BrunoSavard1/CI3-Noeud-de-capteur-/3DModels/Boitier/boitiersc.png

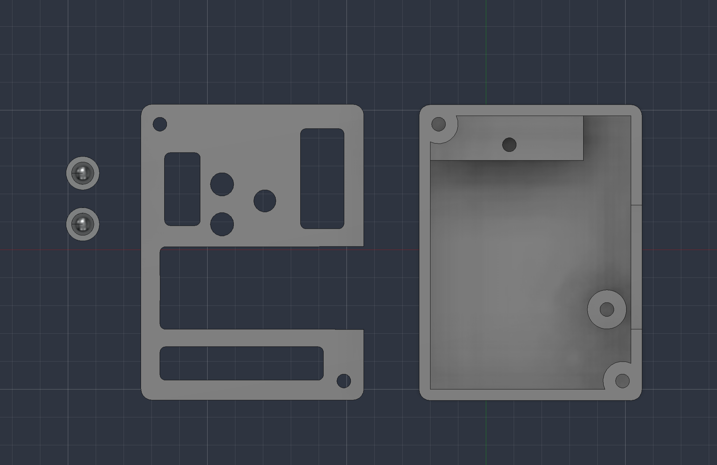
3DModels/Boitier/boitiersc.png
