BrunoSavard1/CI3-Noeud-de-capteur-/3DModels/PCB/pcbdessous.png

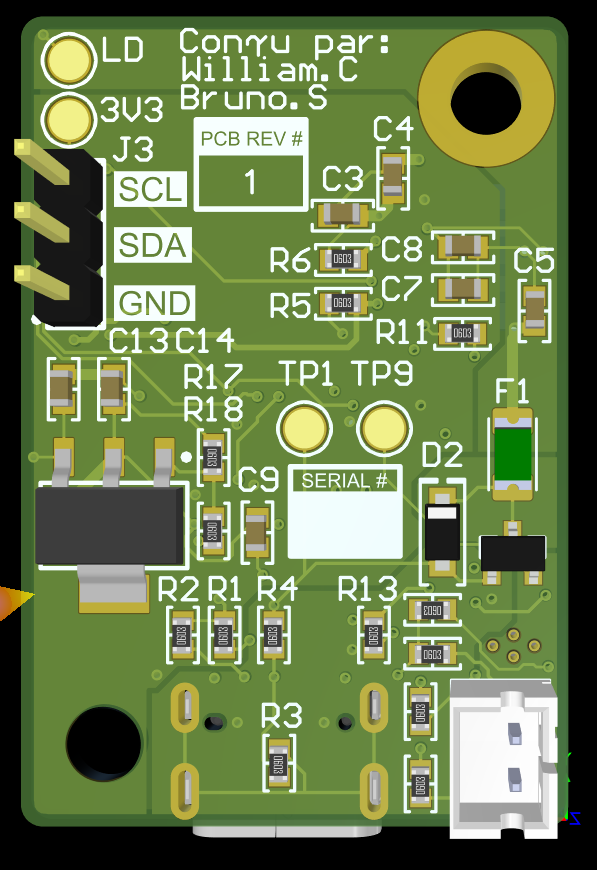
3DModels/PCB/pcbdessous.png
