BrunoSavard1/CI3-Noeud-de-capteur-/3DModels/PCB/pcbdessus.png

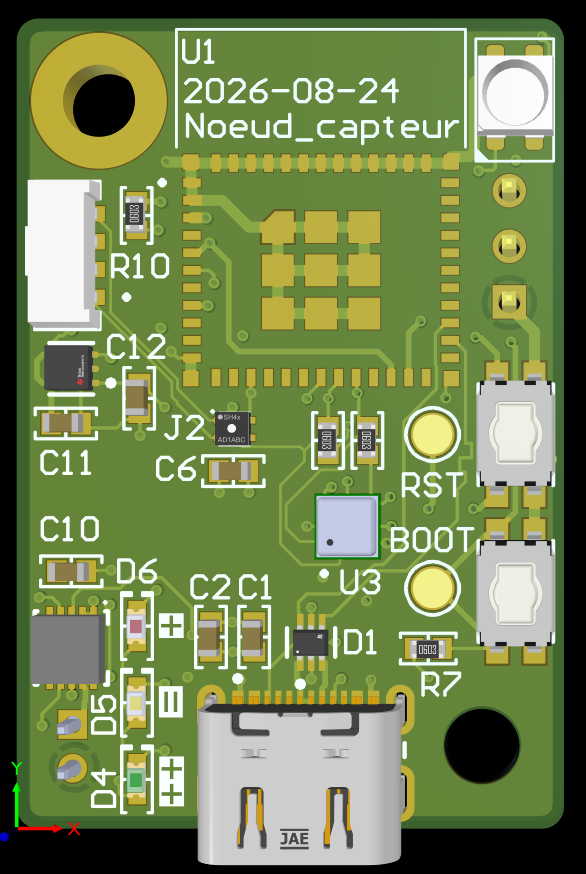
3DModels/PCB/pcbdessus.png
