BrunoSavard1/CI3-Noeud-de-capteur-/PCB/PCB/images/bottom.png

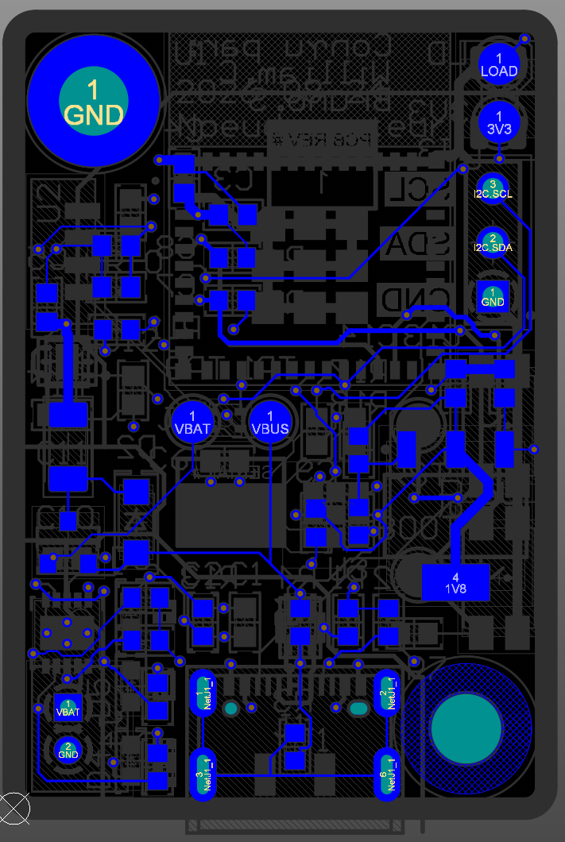
PCB/PCB/images/bottom.png
