BrunoSavard1/CI3-Noeud-de-capteur-/PCB/PCB/images/silkscreenbottom.png

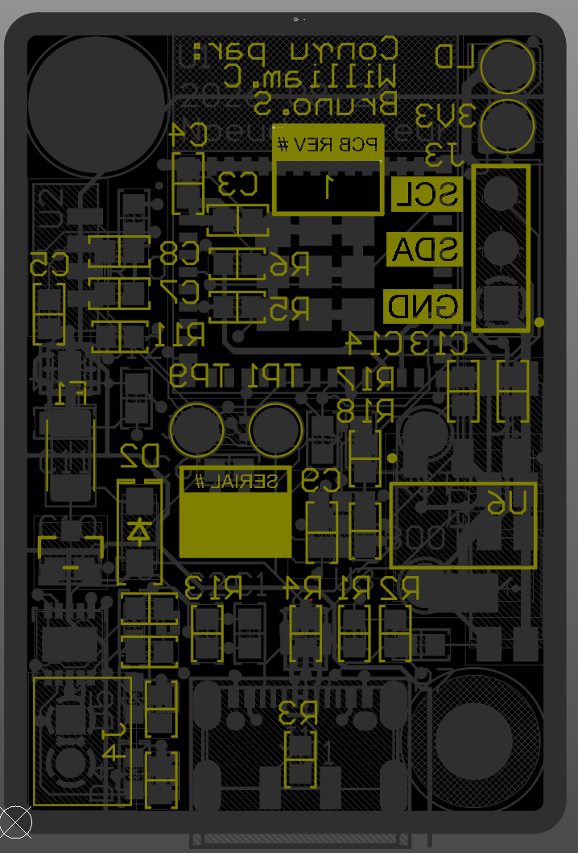
PCB/PCB/images/silkscreenbottom.png
