BrunoSavard1/CI3-Noeud-de-capteur-/PCB/PCB/images/silkscreentop.png

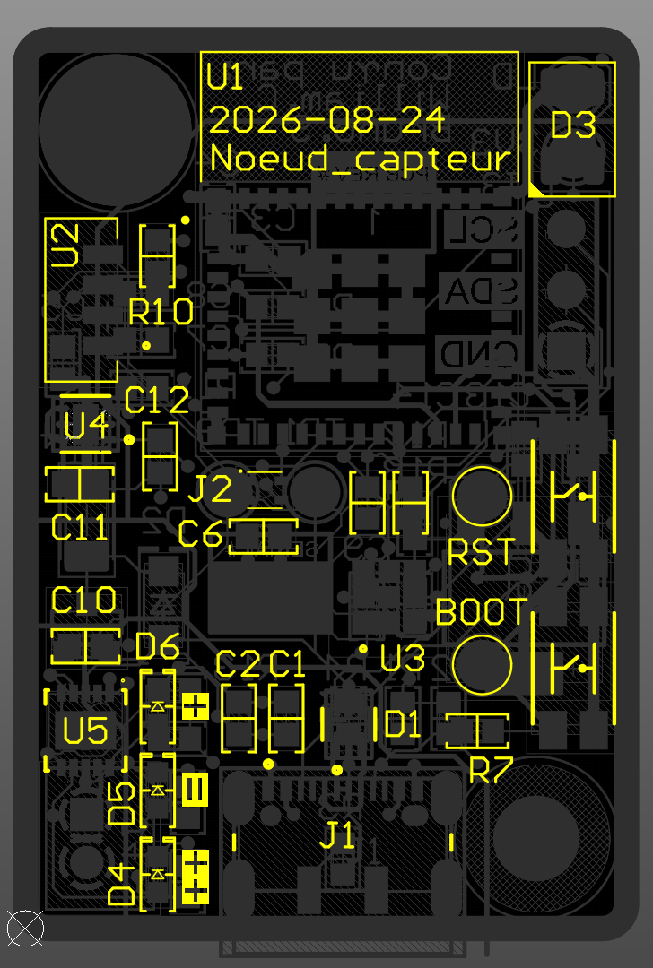
PCB/PCB/images/silkscreentop.png
