BrunoSavard1/CI3-Noeud-de-capteur-/PCB/PCB/images/top.png

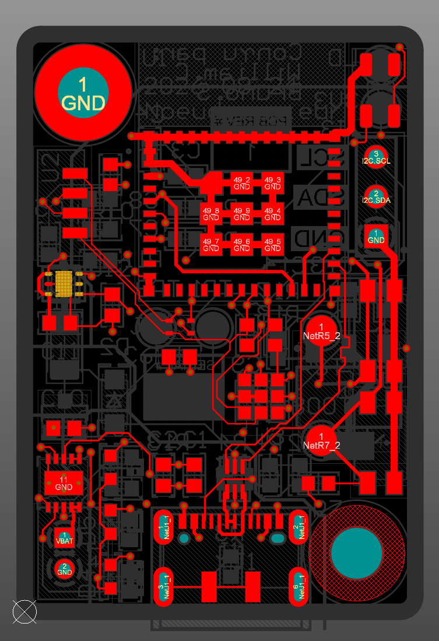
PCB/PCB/images/top.png
