BrunoSavard1/CI3-Noeud-de-capteur-/Schematics/ordinogramme.png

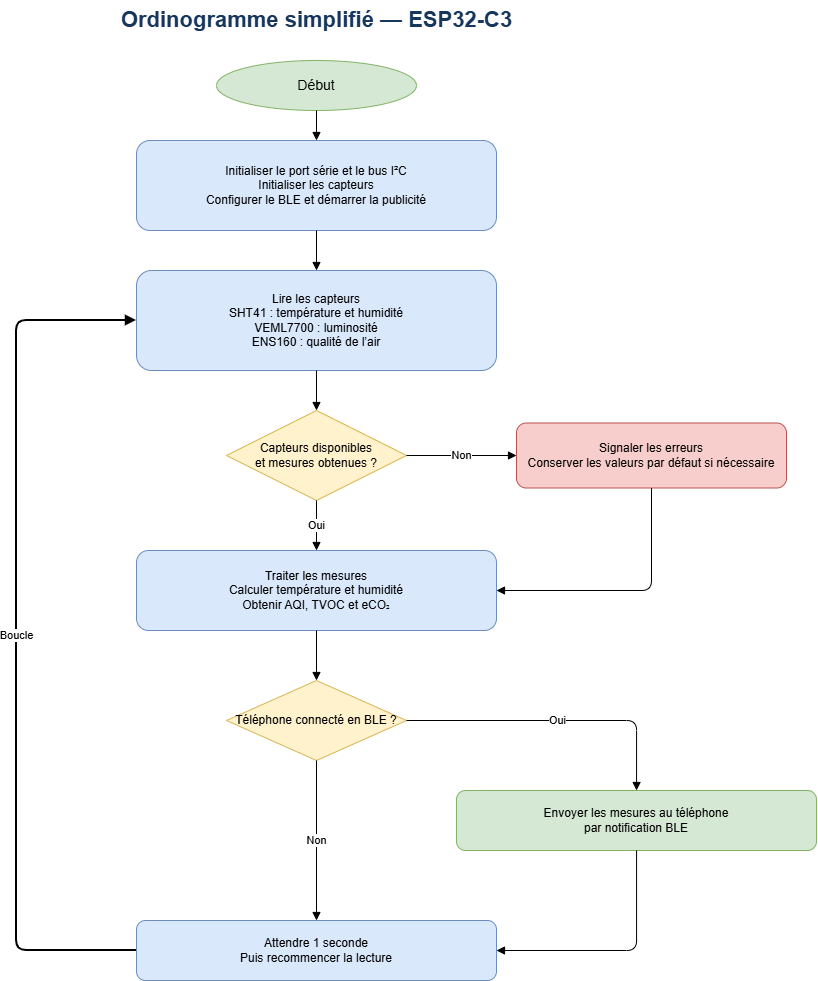
Schematics/ordinogramme.png
