BrunoSavard1/CI3-Noeud-de-capteur-/Schematics/schema_concept_ci3p1V2.drawio.png

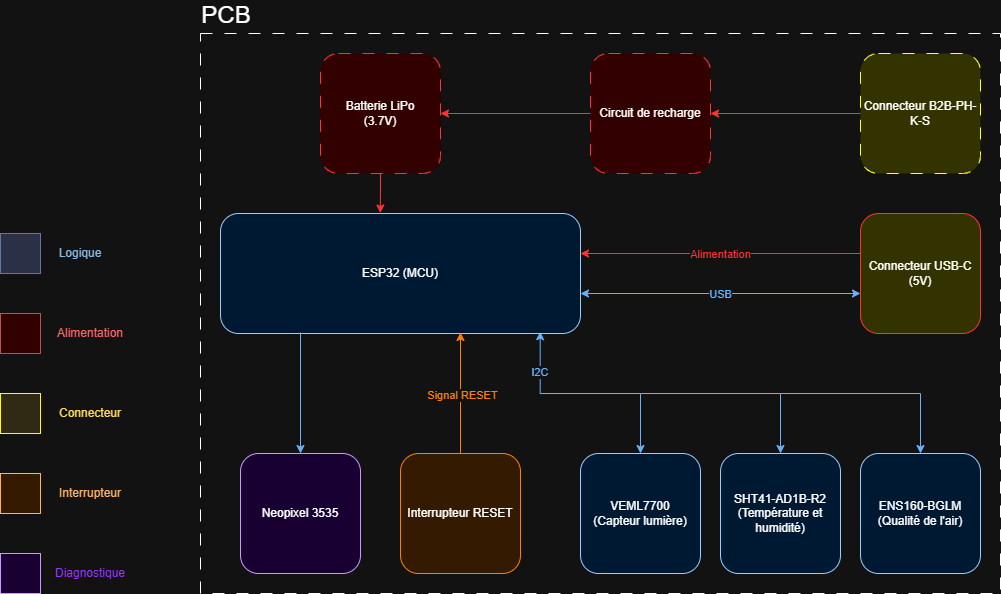
Schematics/schema_concept_ci3p1V2.drawio.png
