BrunoSavard1/CI3-Noeud-de-capteur-/PCB/BOM/noeud_capteur_CWSB_BOM REV 1.00.xlsx

Bill of Material
Board | Noeud_capteurs_CWSB |  | Concepteur Principal |  | William Champagne |  |  | 1
Cours | CI3 (243-554-SH) |  | Date du projet |  | 2026-08-24 |  |  | 00
Département | Technologies du génie électrique |  | Date de génération du BOM |  | 2026-09-11
Révision | 1.00 |  | Heure de génération du BOM |  | 12:04 PM
Nombre de PCB | 1 |  | Variant |  | None
Item # | Designator | Layer | Description | Comment | Package / Case | Supplier 1 | Supplier Part Number 1 | Quantity | Quantity Total | Note
1 | C1, C2, C5, C6, C7, C8, C9 | None | CAP CER 1UF 50V X7R 0603 | 1µF | 0603 (1608 Metric) | DigiKey | 478-10073-1-ND | 7 | 7
2 | C3, C10, C14 | None | CAP CER 10UF 6.3V X5R 0603 | 10 µF | 0603 (1608 Metric) | DigiKey | 490-3896-1-ND | 3 | 3
3 | C4 | None | CAP CER 0.1UF 6.3V X7R 0603 | 0.1 µF | 0603 (1608 Metric) | DigiKey | 709-1009-1-ND | 1 | 1
4 | C11, C12 | None | CAP CER 1UF 16V X7R 0603 | 1 µF | 0603 (1608 Metric) | DigiKey | 399-17704-1-ND | 2 | 2
5 | C13 | None | CAP CER 0.1UF 16V X7R 0603 | 0.1 µF | 0603 (1608 Metric) | DigiKey | 311-3560-1-ND | 1 | 1
6 | D1 | None | TVS DIODE 5.25V 17V SOT666 | USBLC6-2P6 |  |  |  | 1 | 1
7 | D2 | None | DIODE SCHOTTKY 100V 1A SOD123FL | MBR1H100SFT3G | SOD-123F | DigiKey | MBR1H100SFT3GOSCT-ND | 1 | 1
8 | D3 | None | Neopixel Mini 3535 Rgb Leds W/ Integrated Driver Chip - White - Pack Of 10 | Neopixel_3535 |  |  |  | 1 | 1
9 | D4 | None | LED GREEN DIFFUSED 0603 SMD | Green | 0603 (1608 Metric) | DigiKey | 511-1579-1-ND | 1 | 1
10 | D5 | None | LED YELLOW DIFFUSED 0603 SMD | Yellow | 0603 (1608 Metric) | DigiKey | 511-1311-1-ND | 1 | 1
11 | D6 | None | LED RED DIFFUSED 1608 SMD | Red | 0603 (1608 Metric) | DigiKey | SML-D12U1WT86CT-ND | 1 | 1
12 | F1 | None | PTC Resettable Fuse 1A(hold) 1.8A(trip) 6VDC 100A 0.6W 0.3s 0.55Ohm SMD Solder Pad 1206 T/R Automotive | PTC_1.8A_1206 |  |  |  | 1 | 1
13 | IC1 | None | MOSFET P-CH 20V 4A SOT23-3 | DMG3415U-7 | TO-236-3, SC-59, SOT-23-3 | DigiKey | DMG3415UDICT-ND | 1 | 1
14 | J1 | None | CONN RCP USB2.0 TYP C 24P SMD RA | DX07S016JA1R1500 |  |  |  | 1 | 1
15 | J2 | None | Digital Relative Humidity Temperature Sensor, Â±1.8 / max 2.5 %RH, Â±0.2 Â°C, Ultra-Low-Power, with filtermembrane | SHT41-AD1B-R2 |  |  |  | 1 | 1
16 | J3 | None | CON - Header 1x3 pins-100Mils - TH | CON_HDR_1X3 |  |  |  | 1 | 1
17 | J4 | None | Connector Header Through Hole 2 position 0.079 (2.00mm) | B2B-PH-K-S |  |  |  | 1 | 1
18 | R1, R2, R3, R4, R5, R6, R7, R8, R9, R10, R11, R12, R13, R14, R15, R16, R17, R18 | None | RES 150 OHM 5% 1/4W 0603 | 5.1k Ohms, 0 Ohms, 100K Ohms, 10k Ohms, 4.7K Ohms, 10 Ohms, 5.9k Ohms, 470 Ohms, 150 Ohms, 75 Ohms | 0603 (1608 Metric) | DigiKey | 10-ERJ-UP3J151VCT-ND | 18 | 18
19 | S1, S2 | None | SWITCH TACTILE SPST-NO 0.02A 15V | EVQ-P2202M |  |  |  | 2 | 2
20 | U1 | None |  | ESP32-C3-MINI-1-N4 |  |  |  | 1 | 1
21 | U2 | None | Optical Sensor Ambient - IÂ²C 4-SMD, J-Lead | VEML7700-TT |  |  |  | 1 | 1
22 | U3 | None | Air Quality, Carbon Dioxide (CO2), Metal Oxide (MOX) Sensor IÂ²C, SPI | ENS160-BGLM |  |  |  | 1 | 1
23 | U4 | None | IC REG LINEAR 3.3V 500MA 6SON | LP5912-3.3DRVT |  |  |  | 1 | 1
24 | U5 | None | Stand-Alone Linear Li-Ion/Li-Polymer Charge Management Controller with Power-Good Output, 4.2V, 10-Pin DFN, Industrial Temperature, Tape and Reel | MCP73833T-FCI/MF |  |  |  | 1 | 1
25 | U6 | None | 800mA Low-Dropout Linear Regulator, 4-pin SOT-223, Pb-Free | LM1117MPX-ADJ/NOPB |  |  |  | 1 | 1
Commentaires ou instruction spécialies
