BrunoSavard1/CI3-Noeud-de-capteur-/3DModels/Boitier/Bruno_Savard_STL_Assemblage_boitier_PCB.stl

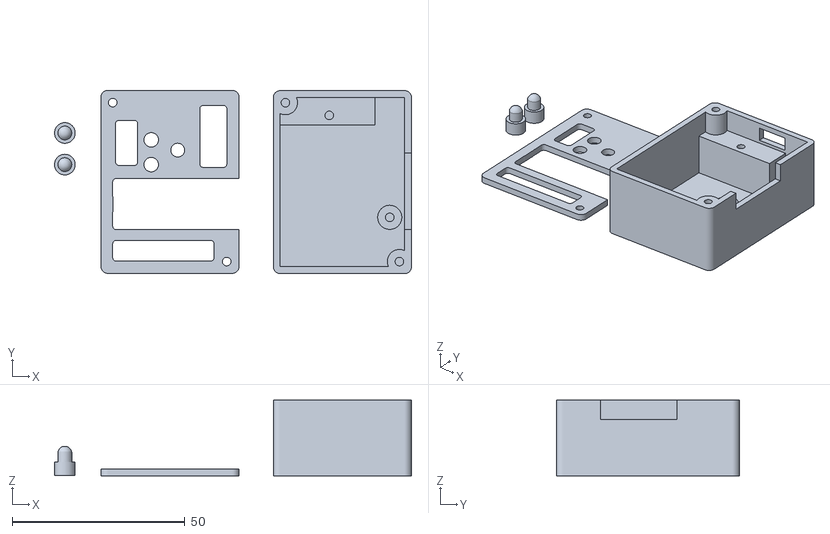
[picture p11: CAD file, 2026-10-19]
3DModels/Boitier/Bruno_Savard_STL_Assemblage_boitier_PCB.stl
103.4 x 53.1 x 22.0
