BrunoSavard1/CI3-Noeud-de-capteur-/3DModels/Boitier/bouton.stl

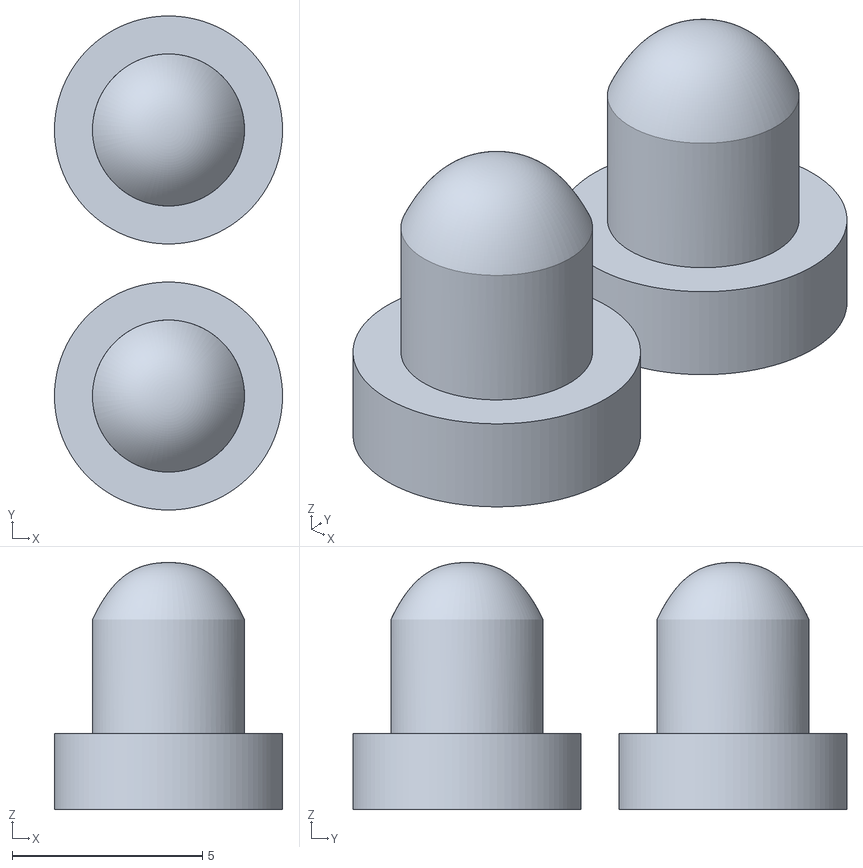
[picture p12: CAD file, 2026-10-19]
3DModels/Boitier/bouton.stl
6.00 x 13.0 x 6.50
