BrunoSavard1/CI3-Noeud-de-capteur-/3DModels/NC_PCB_4L_MODEL3D.step

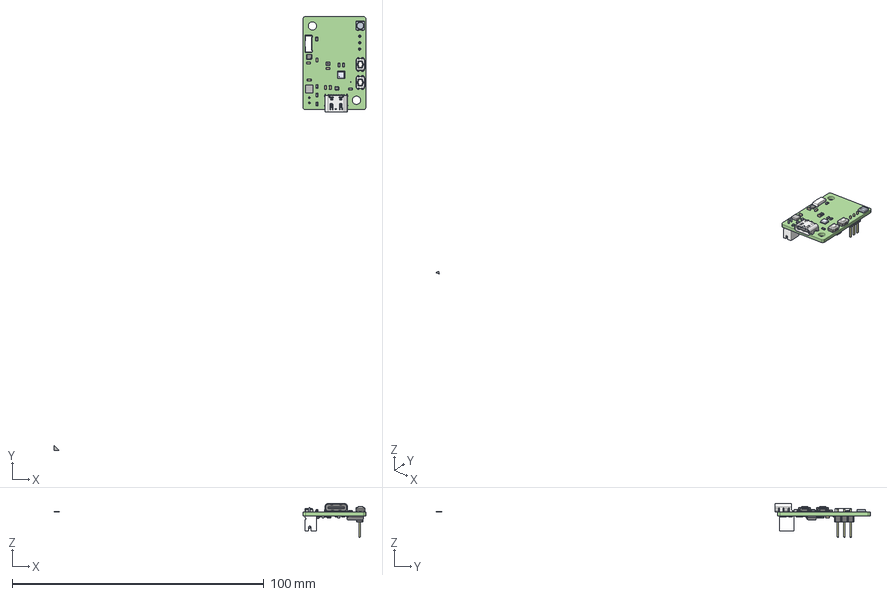
[picture p13: CAD file, 2026-09-14]
3DModels/NC_PCB_4L_MODEL3D.step
123.8 x 172.3 x 13.5 mm
Extruded x 8
0603 resistor x 18
SOT-223
BODY-SON
FRAME-DRV0006B
Texas Logo Yury
Texas Logo Yury - Copy
Panasonic - EVQP2 x 2
User Library-Header_Male_3Pin_PinArray
User Library-Header_Male_3Pin_BodyArray
JAE
sot-23-3
0ZCJ0100FF2E
LED 0603 Base RED
LED 0603 Lens RED
LED 0603 Base YELLOW
LED 0603 Lens YELLOW
LED 0603 Base GREEN
LED 0603 Lens GREEN
SOD123F
STM Logo
0603 cap x 14
