BrunoSavard1/CI3-Noeud-de-capteur-/Guides/guide_user.md

**1.** Alimenter le dispositif par USB-C ou par la batterie.

**2.** Installer et ouvrir nRF Connect for Mobile sur un téléphone compatible.

**3.** Rechercher le périphérique BLE nommé ESP32-C3-BLE-SEVVV.
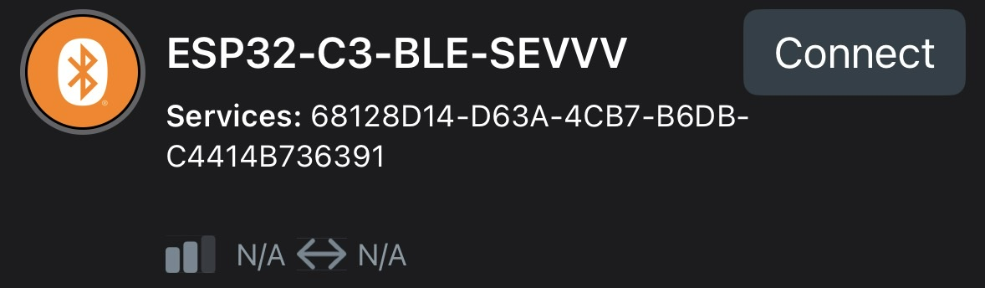
[picture p14: Guides/images/ble_support1.png]


**4.** Se connecter au périphérique, puis activer la reception de donner comme ci:
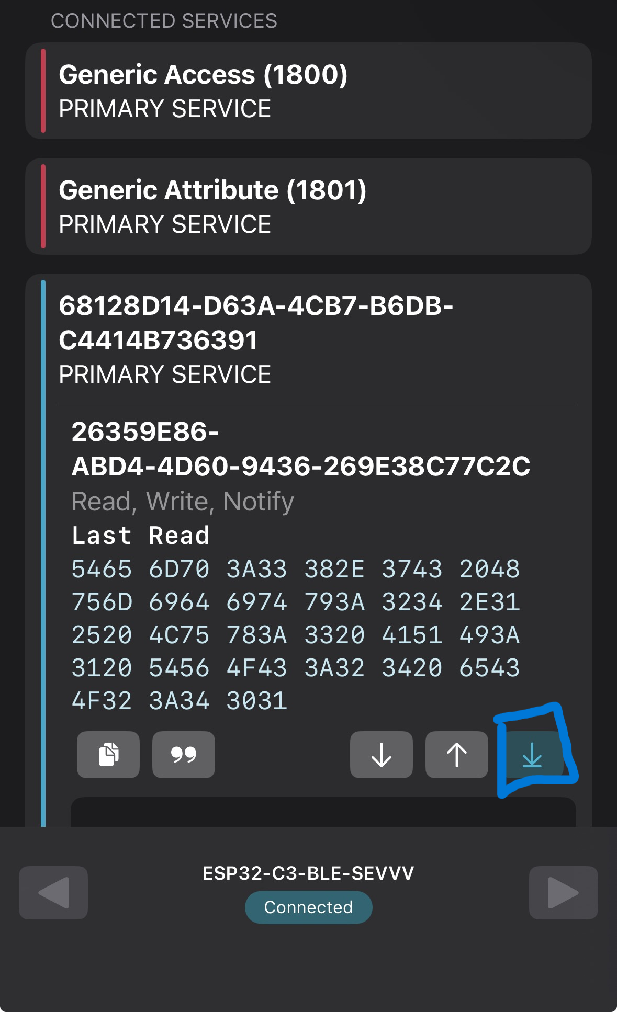
[picture p15: Guides/images/ble_support2.png]


**5.** Activer maintenant la décryption de donner comme ci:
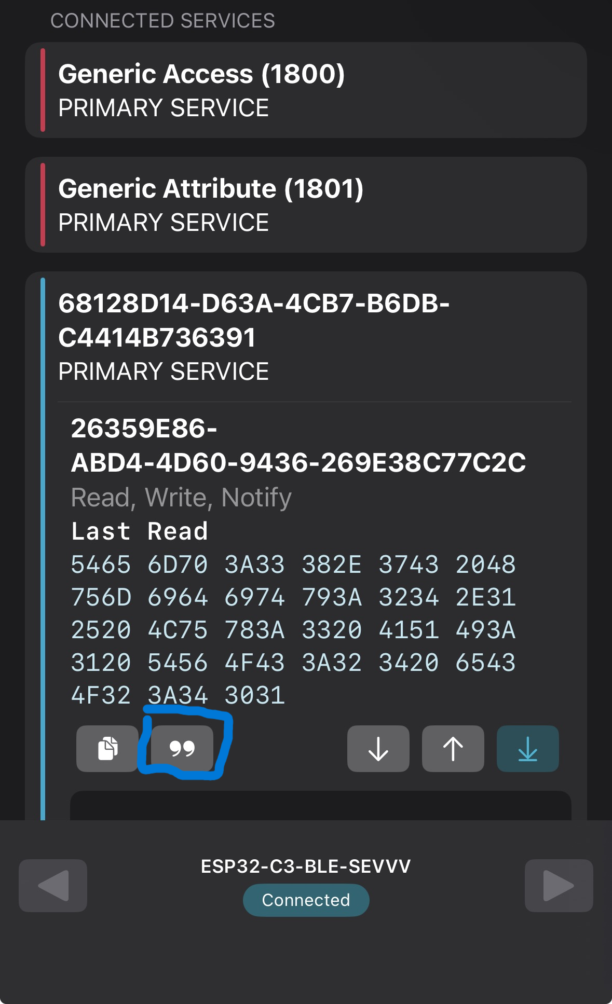
[picture p16: Guides/images/ble_support3.png]


**6.** Vous devriez avoir un résultat similaire à ceci:
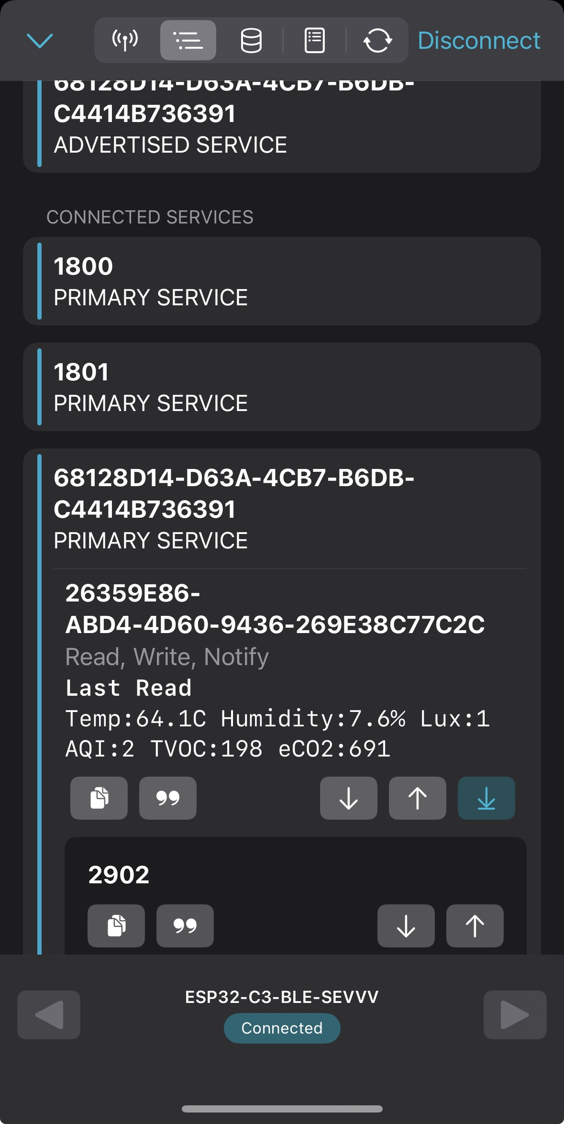
[picture p17: Guides/images/ble_support4.png]
