BrunoSavard1/CI3-Noeud-de-capteur-/Plan de tests/PlanTest_Info.xlsx

Sheet: Tests
 | Plan de tests
Nom du PCB |  | Préparé par
Cours |  | Testeur
Département | Technologies du génie électrique | date
Révision du PCB
Fonction | Description du test | Résultat | Raison réussite ou échec | modification effectuée | Nouveau résultat | Commentaire
Unitaire |  | Réussi
Unitaire | Test conditionelle C1: | Réussi

Sheet: Modification 2ième version
# | Modification suggérée | Explication
1 | Agrandir les silkscreens d'informations. | Les silkscreens d'information ont mal imprimés. Il sont peut être trop petit.
2 | Garder le header de debug sur la partie non isolé. | Le header de debug fait un pont entre les deux zones du pcb et cela peut causer du bruit
3 | Raccourcir les traces entre les condensateur de découplage et leur patte. | Pour réduire le bruit, ce qui rend le MCU et les IC plus stable.
4 | Silkscreen d'information pour le header J1. | Information permettant de plus facilement voir ou brancher le VCC et le GND sur le header J1.
5 | Ajouter un connecteur I2C pour cable stemma QT. | Cela permettrait de plus facilement et rapidement connecter le périphérique avec un autre périphérique I2C pour lire la tramme
6
7
8
9
10
11
12
13
