BrunoSavard1/CI3-Noeud-de-capteur-/Plan de tests/Informatique/PDTINFO_NOEUD_CAPTEUR.xlsx

Sheet: Tests
 | Plan de tests
Nom du PCB |  | Préparé par | William Champagne
Cours |  | Testeur | William Champagne
Département | Technologies du génie électrique | date
Révision du PCB
Fonction | Description du test | Résultat | Raison réussite ou échec | modification effectuée | Nouveau résultat | Commentaire
Intégration | Enclencher le mode programmation en suivant ces étapes: 1. Alimenter le board. 2. Après quelques secondes, maintenir le bouton RESET enfoncé, puis appuyer sur le bouton BOOT. 3. Relâcher le bouton RESET, puis attendre quelques secondes avant de relâcher également le bouton BOOT. Cela devrait activer le mode programmation et vous permettre de programmer le board. | Réussi | Avant l'enclechement du mode programmation, le ESP32 semblait se connecter et deconnecter (observer à l'aide de device manager). Une fois le mode programmation activer, le ESP32 restait connecté.
Intégration | À l'aide de l'extension PlatformIO, uploader le code. Le processus de détection du port et de l'envoie de données se fait automatiquement. | Réussi | Le code à été uploadé correctement.
Fonctionnel | Observer si la NeoPixel allume en vert. | Échec | La NeoPixel est blanche | Changer la librairie FastLED et utilise plutôt les fonctions de gestions de lumières natives de Arduino - neopixelWrite(); | Réussi | La NeoPixel est verte. Nous pouvons maintenant contrôller la NeoPixel comme nous voulons.
Intégration | En utilisant le port série. Observer les données des capteurs envoyées par l'ESP32. Le port série devrait ressembler à ceci: SHT_RH: * SHT_Temp: * luxval: * AQI: * (*) TVOC: * ppb eCO2: * ppm Si la communication ne fonctionne pas, tenter test C1 | Échec | Le code se bloque sur l'initialisation d'un capteur qui refuse de répondre. | L'initalisation I2C ne s'éffectuait pas. Nous avons donc ajouter cette initialisation. | Réussi | Tout les capteurs s'initialisent et les résultat dans le port série sont correctes.
Fonctionnel | Soufler sur le board, la valeur eCO2 devrait monter | Réussi | en souflant sur le capteur, la valeur eCO2 monte considérablement.
Fonctionnel | Cacher le board avec votre main ou un objet. La valeur lux devrait baisser. | Réussi | La valeur lux descend jusqu’à 0 comparer a 120 - 150 quand le board n'est pas caché.
Fonctionnel | Couvrer le board. Attendre 10 à 20 secondes. La température devrait avoir augmentée | Réussi | La température a monter d'environ 10 degrée
Fonctionnel | À l'aide de l'application nRF connect sur mobile, connectez vous sur votre ESP32 (il devrait paraitre sous ce nom: ESP32-C3-BLE-SEVVV). La lumière de la NeoPixel devrait devenir bleu. | Réussi | La NeoPixel devient bleu et l'ESP32 figure sous le nom: ESP32-C3-BLE-SEVVV
Intégration | Observer les données envoyées par bluetooth. Elles devrait correspondrent à celle envoyées sur le port série. | Réussi | Les données correspondent parfaitement.
 | Test conditionnel
Fonctionnel | À l'aide du header I2C sur le PCB, utiliser un analyseur logique pour diagnostiquer une cause potentiel. (Souder le header I2C au besoin)

Sheet: Modification 2ième version
# | Modification suggérée | Explication
1
2
3
4
5
6
7
8
9
10
11
12
13
