BrunoSavard1/CI3-Noeud-de-capteur-/Plan de tests/Electrique/PDTELEC_NOEUD_CAPTEUR.xlsx

Sheet: Tests
 | Plan de tests
Nom du PCB |  | Préparé par | Bruno Savard
Cours |  | Testeur | Bruno Savard
Département | Technologies du génie électrique | date
Révision du PCB
Fonction | Description du test | Résultat | Raison réussite ou échec | modification effectuée | Nouveau résultat | Commentaire
Unitaire | Effectuer une inspection visuelle de la carte PCB afin de détecter tout défaut apparent, notamment les désignateurs peu visibles, les composants endommagés ou manquants, les fissures sur la carte ainsi que les traces de cuivre endommagées ou manquantes. | Réussi | Une inspection visuelle de la carte PCB a été effectuée afin de vérifier l’état général de la carte. Le bouton **BOOT** est endommagé, mais demeure fonctionnel et a été testé à l’oscilloscope. Le **MOSFET** n’est pas présent sur le PCB puisqu’il n’a pas encore été reçu. Pour le reste, la carte est en bon état. Aucun autre défaut apparent n’a été observé : les désignateurs sont visibles, aucune fissure n’est présente sur la carte et aucune trace de cuivre n’est visiblement endommagée ou manquante. Aucun autre composant prévu ne semble manquer.
Unitaire | Vérifier que les connecteurs et les commandes de la carte sont accessibles lorsque celle-ci est installée dans le boîtier. S’assurer qu’il y a suffisamment d’espace pour accéder au connecteur USB-C, au connecteur de la batterie, aux boutons Reset et Boot, ainsi qu’au header permettant de vérifier le trafic I2C. | Réussi | Tous les connecteurs et commandes ont été vérifiés et sont fonctionnels. Le connecteur USB-C, le connecteur de la batterie ainsi que les boutons Reset et BOOT sont accessibles lorsque la carte est installée dans le boîtier. Le header I2C sera dessoudé afin de permettre l’installation de la carte dans le boîtier.
Unitaire | À l'aide du multimètre, faire un test de continuité entre les points de tests d'alimentations (VBUS ; 3v3 ; VBAT,LD).Il ne devrait pas avoir aucun court circuit entre les alimentations et leur GND. | Réussi | 3,3 GND (1,1Mohms) (Vbus 92Kohms) LD (0,12Mohms)
Intégration | À l’aide d’un oscilloscope ou d'un multimètre (test de continuité), vérifier le point de test du signal Reset. Appuyer sur le bouton Reset et vérifier que la tension du signal Reset descend à environ 0 V lorsque le bouton est enfoncé. | Réussi | En éffectuant un test de continuité, on observe un fonctionnement adéquat du bouton Reset.
Fonctionnel | À l’aide d’un oscilloscope ou d'un multimètre (test de continuité), vérifier le point de test du signal Boot. Appuyer sur le bouton Boot et vérifier que la tension du signal Boot descend à environ 0 V lorsque le bouton est enfoncé. | Réussi | En éffectuant un test de continuité, on observe un fonctionnement adéquat du bouton Boot.
Unitaire | Prendre une mesure de résistance sur R1 et R2. Les mesures des deux résistances devraient être environ 5.1k Ohms. Cela assure que la tension fournie par le connecteur USB-C est de 5V. | Réussi | R1 et R2 sont a 5,09K Ohms le connecteur USB-C devrait bien aavoir une tension de 5V environs
Intégration | **Smoke test 1 :** Alimenter le circuit à l’aide d’un câble USB-C seulement et vérifier qu’aucun composant ne brûle ou ne chauffe excessivement, au point de devenir dangereux au toucher. | Échec | Lors de l’alimentation du circuit par USB-C, le circuit de protection USB-C a brûlé en raison d’un court-circuit dans le circuit de recharge de la batterie. | Remplacer le circuit de protection USB-C endommagé par un nouveau. | Réussi | Aucun composant n’a brûlé ni été endommagé lors du rebranchement du circuit.
Fonctionnel | TEST : A À l’aide d’un multimètre, mesurer la tension aux différents points de test d’alimentation. S’assurer que les tensions indiquées sur le PCB correspondent aux valeurs attendues (5 V et 3,3 V), avec une marge de tolérance d’environ ±3 %. Si aucune tension est observer sur VBUS, éffectuer le test C1 | Réussi | Les tensions attendues sont bien mesurées aux points de test VBUS (5,01 V) et 3,3 V (3,249 V).
Fonctionnel | **Smoke test 2 :** Alimenter le circuit à l’aide de la batterie seulement et vérifier qu’aucun composant ne brûle ou ne chauffe excessivement, au point de devenir dangereux au toucher. Une fois la vérification effectuée, refaire le TEST A. | Échec | Le connecteur de la batterie était inversé sur le PCB, ce qui a envoyé une tension de 4,2 V sur le GND et provoqué la destruction du circuit intégré de recharge de la batterie. | Dessouder la chip de recharge de la batterie et ne pas en mettre d'autre | Réussi | Le circuit d’alimentation par batterie ne fonctionne pas en raison de la défaillance de la puce de recharge. Le retrait de cette puce permet toutefois de rétablir le fonctionnement de l’alimentation par câble USB-C.
Fonctionnel | **Smoke test 3 :** Alimenter le circuit à l’aide de la batterie et d’un câble USB-C simultanément. Vérifier qu’aucun composant ne brûle ou ne chauffe excessivement, au point de devenir dangereux au toucher. Une fois la vérification effectuée, refaire le **TEST A**. | Échec | La partie USB-C fonctionne correctement. Toutefois, les circuits intégrés et le MOSFET associés à l’alimentation par batterie ont été dessoudés afin de permettre au PCB de fonctionner uniquement avec l’alimentation USB-C.
 | Tests Contionnels.
Unitaire | C1: À l'aide du multimètre, éffectuer un test de diode sur la diode D1 et assurez vous de la polarité.

Sheet: Modification 2ième version
# | Modification suggérée | Explication
1 | Agrandir les silkscreens d'informations. | Les silkscreens d'information ont mal imprimés. Il sont peut être trop petit.
2 | Garder le header de debug sur la partie non isolé. | Le header de debug fait un pont entre les deux zones du pcb et cela peut causer du bruit
3 | Raccourcir les traces entre les condensateur de découplage et leur patte. | Pour réduire le bruit, ce qui rend le MCU et les IC plus stable.
4 | Silkscreen d'information pour le header J1. | Information permettant de plus facilement voir ou brancher le VCC et le GND sur le header J1.
5 | Ajouter un connecteur I2C pour cable stemma QT. | Cela permettrait de plus facilement et rapidement connecter le périphérique avec un autre périphérique I2C pour lire la tramme
6
7
8
9
10
11
12
13
