BrunoSavard1/CI3-Noeud-de-capteur-/Plan de tests/Electrique/PDTELEC_NOEUD_CAPTEUR_V2.xlsx

Sheet: Tests
 | Plan de tests
Nom du PCB |  | Préparé par | Bruno Savard et William Champagne
Cours |  | Testeur | William Champagne
Département | Technologies du génie électrique | date
Révision du PCB
Fonction | Description du test | Résultat | Raison réussite ou échec | modification effectuée | Nouveau résultat | Commentaire
Unitaire | Effectuer une inspection visuelle de la carte PCB afin de détecter tout défaut apparent, notamment les désignateurs peu visibles, les composants endommagés ou manquants, les fissures sur la carte ainsi que les traces de cuivre endommagées ou manquantes. | Réussi | Une inspection visuelle de la carte PCB a été effectuée afin de vérifier l’état général de la carte. Le bouton **BOOT** et **RESET** sont quelques peu élevés, le capteur ens160 (U3) est un peu croche, le connecteur de la batterie n'a pas de "casing" (résultat voulue) et il reste du résidue de flux (no clean flux) sur le board. Il y a donc seulement des "anomalies" esthétiques. Pour le reste, la carte est en bon état. Aucun autre défaut apparent n’a été observé : les désignateurs sont visibles, aucune fissure n’est présente sur la carte et aucune trace de cuivre n’est visiblement endommagée ou manquante. Aucun autre composant prévu ne semble manquer.
Unitaire | Vérifier que les connecteurs et les commandes de la carte sont accessibles lorsque celle-ci est installée dans le boîtier. S’assurer qu’il y a suffisamment d’espace pour accéder au connecteur USB-C, au connecteur de la batterie, aux boutons Reset et Boot, ainsi qu’au header permettant de vérifier le trafic I2C. | Réussi | Tous les connecteurs et commandes ont été vérifiés et sont fonctionnels. Le connecteur USB-C, le connecteur de la batterie ainsi que les boutons Reset et BOOT sont accessibles lorsque la carte est installée dans le boîtier. Le header I2C sera dessoudé afin de permettre l’installation de la carte dans le boîtier.
Fonctionnel | À l'aide du multimètre, faire un test de continuité et mesurer la résistance entre les points de tests d'alimentations (VBUS ; 3v3 ; VBAT,LD) en utilisant leur point de tests prédéfinis.Il ne devrait pas avoir aucun court circuit ou de résistance trop faible entre les alimentations et leur GND. | Réussi | 3V3: 10-30Kohms (dépend de l'essaie), Vbus: 92Kohms, LD: 0,12Mohms, VBAT: 10.2Mohms (non connecté) - 3V3 est un peu bas mais reste acceptable (Leak current: 0.33mA max)
Unitaire | À l’aide d’un oscilloscope ou d'un multimètre (test de continuité), vérifier le point de test du signal Reset. Appuyer sur le bouton Reset et vérifier que la tension du signal Reset descend à environ 0 V lorsque le bouton est enfoncé. | Réussi | En éffectuant un test de continuité, on observe un fonctionnement adéquat du bouton Reset.
Unitaire | À l’aide d’un oscilloscope ou d'un multimètre (test de continuité), vérifier le point de test du signal Boot. Appuyer sur le bouton Boot et vérifier que la tension du signal Boot descend à environ 0 V lorsque le bouton est enfoncé. | Réussi | En éffectuant un test de continuité, on observe un fonctionnement adéquat du bouton Boot.
Intégration | Prendre une mesure de résistance sur R1 et R2. Les mesures des deux résistances devraient être environ 5.1k Ohms. Cela assure que la tension fournie par le connecteur USB-C est de 5V. | Réussi | R1 et R2 sont a 5,098K Ohms le connecteur USB-C devrait bien aavoir une tension de 5V environs
Intégration | **Smoke test 1 :** Alimenter le circuit à l’aide d’un câble USB-C seulement et vérifier qu’aucun composant ne brûle ou ne chauffe excessivement, au point de devenir dangereux au toucher. | Réussi | Lors de l’alimentation du circuit par USB-C, le circuit de protection USB-C a brûlé en raison d’un court-circuit dans le circuit de recharge de la batterie.
Fonctionnel | À l’aide d’un multimètre, mesurer la tension aux différents points de test d’alimentation. S’assurer que les tensions indiquées sur le PCB correspondent aux valeurs attendues (5 V et 3,3 V), avec une marge de tolérance d’environ ±3 %. Si aucune tension est observer sur VBUS, éffectuer le test C1 (Voir plus bas). | Réussi | Les tensions attendues sont bien mesurées aux points de test VBUS: 5,01V, 3V3 V: 3,3018V, LD: 4.28V (branché USB), VBAT: 4.17V à 3.82V (dépend de le charge)
Fonctionnel | Brancher la batterie (AVEC LA BONNE POLARITÉ) et observer si les DELs de diagnostiques allument. Si les DELs ne s'allument pas, éffectuer le test C2 (Voir plus bas). | Réussi | D6 (Chargement de batterie) et D4 (Alimentation USB-C) allument comme prévue.
Intégration | Brancher le board dans un ordinateur via USB-C. Votre ordinateur devrait détecter votre board. | Échec | Utilisant un cable capable de communiquer, mon ordinateur voit quelque chose brancher dans le port USB( C ), mais est incapable de communiquer avec (code 43). | La TVS était à l'envers, nous avons donc corriger l'orientation de la TVS | Réussi | Le board est maintenant reconnue parfaitement par l'ordinateur. Double check l'orientation!
 | Tests Contionnels.
Unitaire | C1: À l'aide du multimètre, éffectuer un test de diode sur la diode D1 et assurez vous de la polarité.
Unitaire | C2: Vérifier que la polarité de la DEL correspond à la polarité indiqué sur le board.

Sheet: Modification 2ième version
# | Modification suggérée | Explication
1 | Agrandir les silkscreens d'informations. | Les silkscreens d'information ont mal imprimés. Il sont peut être trop petit.
2 | Garder le header de debug sur la partie non isolé. | Le header de debug fait un pont entre les deux zones du pcb et cela peut causer du bruit
3 | Raccourcir les traces entre les condensateur de découplage et leur patte. | Pour réduire le bruit, ce qui rend le MCU et les IC plus stable.
4 | Silkscreen d'information pour le header J1. | Information permettant de plus facilement voir ou brancher le VCC et le GND sur le header J1.
5 | Ajouter un connecteur I2C pour cable stemma QT. | Cela permettrait de plus facilement et rapidement connecter le périphérique avec un autre périphérique I2C pour lire la tramme
6
7
8
9
10
11
12
13
