BrunoSavard1/CI3-Noeud-de-capteur-/Plan de tests/Mécanique/PDTMEC_NOEUD_CAPTEUR.xlsx

Sheet: Tests
 | Plan de tests
Nom du PCB |  | Préparé par | William Champagne
Cours |  | Testeur | William Champagne
Département | Technologies du génie électrique | date
Révision du PCB
Fonction | Description du test | Résultat | Raison réussite ou échec | modification effectuée | Nouveau résultat | Commentaire
Intégration | Faire une inspection visuelle du boitier. | Réussi | Le boitier n'a aucun défaut de fabrication.
Intégration | Insérer le board assemblé et observer s'il rentre et peu être visé au boitier. | Réussi | Le board rentre (incluant la batterie) et peu être visé au boitier
Fonctionnel | Visé le couvercle sur le reste du boitier avec les boutons | Échec | Les boutons sont trops grands et appuient sur les boutons RESET et BOOT continuellement | Impression de boutons plus petits | Réussi | Les boutons fonctionnent maintenant comme prévue.

Sheet: Modification 2ième version
# | Modification suggérée | Explication
1
2
3
4
5
6
7
8
9
10
11
12
13
