BrunoSavard1/CI3-Noeud-de-capteur-/Journal/Journal_Bruno_CI3_Noeud_capteur.docx

## Cours 0 — Cahier des charges

**Travail prévu :** Déterminer les requis du projet et commencer à préparer la conception du schéma électrique.

**Travail réalisé :** On a fait le cahier des charges pour déterminer les requis obligatoires et les contraintes à respecter pendant la conception du schéma électrique. On a aussi choisi le modèle d’ESP32 qu’on allait utiliser et les requis optionnels qu’on voulait ajouter au projet.

**Problèmes rencontrés :** Cette étape nous a permis de mieux définir les besoins du projet avant de commencer le schéma électrique.

## Cours 1 — Schéma électrique et recherche des composants

**Travail prévu :** Travailler sur le schéma électrique et rechercher les composants nécessaires.

**Travail réalisé :** Will et moi avons travaillé sur le schéma électrique et corrigé le cahier des charges. On a aussi recherché les composants nécessaires au projet. Au départ, on avait choisi un ESP32-WROOM, mais on a finalement changé de modèle pour avoir un microcontrôleur qui consomme moins et qui prend moins de place sur le PCB.

**Problèmes rencontrés :** On a dû revoir notre choix de microcontrôleur pour mieux respecter les contraintes de consommation et d’espace.

## Cours 2 — Vérification du schéma et plan de test

**Travail prévu :** Vérifier le schéma électrique, commencer le routage du PCB et préparer le plan de test.

**Travail réalisé :** Au début du cours, on a vérifié le schéma électrique avant de laisser Will commencer le routage, pour s’assurer que tout était correct. On a ajouté des points de test et les éléments de démarrage nécessaires au microcontrôleur. Pendant que Will faisait le routage, j’ai commencé le plan de test du PCB.

**Problèmes rencontrés :** J’ai eu des problèmes avec Altium. Comme j’avais changé d’ordinateur, j’avais perdu mes configurations et mes connexions. J’ai dû réinstaller toutes les bibliothèques, refaire les connexions et remettre Altium à jour. Ça m’a pris plus de temps que prévu, puisque j’ai dû retrouver et reconfigurer tout ce que j’avais sur mon ancien ordinateur.

## Cours 3 — Conception du boîtier 3D

**Travail prévu :** Concevoir le boîtier 3D, ajouter les tests mécaniques au plan de test et poursuivre les recherches sur la programmation des composants.

**Travail réalisé :** J’ai commencé à concevoir le boîtier 3D sur Fusion 360. J’ai travaillé sur sa forme et ses dimensions pour essayer de le rendre le plus compact possible.

**Problèmes rencontrés :** La conception m’a pris toute la période, parce que j’ai dû réinstaller Fusion 360, reconnecter mon compte du cégep et me remettre en mémoire le fonctionnement du logiciel. J’ai dû recommencer plusieurs fois à cause de différents problèmes. Le principal problème était de faire un boîtier compact, puisque le PCB est presque de la même taille que la batterie et qu’on doit utiliser des vis M3. Finalement, le boîtier sera un peu plus grand que prévu, mais il devrait être plus fonctionnel et plus facile à assembler. Comme la conception a pris toute la période, je n’ai pas pu avancer autant que prévu sur les autres tâches, notamment les tests mécaniques et la programmation.

## Cours 4 — Correction du boîtier et documentation

**Travail prévu :** Assembler le PCB et poursuivre la documentation ainsi que le plan de test.

**Travail réalisé :** On était prêts à commencer l’assemblage du PCB, mais on n’avait pas reçu les pièces nécessaires. J’ai donc corrigé le dessus du boîtier, puisqu’il manquait d’aération pour les capteurs et que le capteur de lumière était enfermé dans le boîtier. J’ai ajouté une extrusion autour du capteur pour permettre à la lumière de l’atteindre sous différents angles. J’ai aussi fait la documentation du travail réalisé depuis le premier cours et préparé mes notes pour la présentation, notamment les problèmes rencontrés, les améliorations possibles et ce qui avait bien fonctionné.

**Problèmes rencontrés :** Le fait de ne pas avoir reçu les pièces nous a empêchés de commencer l’assemblage comme prévu. On a donc dû changer nos tâches pendant cette période, ce qui a retardé l’assemblage du PCB.

## Cours 5 — Assemblage du PCB

**Travail prévu :** Assembler le PCB, effectuer les premiers tests et apporter les réparations nécessaires pour avancer vers un prototype fonctionnel.

**Travail réalisé :** On a finalement reçu les pièces pendant le cours. J’ai donc commencé l’assemblage du PCB, ce qui m’a pris environ trois heures et demie. J’ai utilisé un stencil pour faire les soudures des composants, puis j’ai poursuivi l’assemblage de la carte. Une fois l’assemblage terminé, j’ai passé le PCB à Will pour qu’on puisse essayer de l’installer dans le boîtier.

**Problèmes rencontrés :** Ça faisait longtemps que je n’avais pas utilisé de stencil. J’ai dû reprendre les différentes étapes de la procédure et vérifier que tout était bien fait. Comme Dave n’était pas là pour nous aider, j’ai fait l’assemblage seul, ce qui m’a pris plus de temps. J’ai aussi eu quelques problèmes de court-circuit après le passage au four et j’ai dû faire des réparations avant de poursuivre avec la soudure des composants sur la face inférieure. Finalement, pendant qu’on essayait d’installer le PCB dans le boîtier, la carte a cessé de fonctionner. J’avais passé presque toute la période sur l’assemblage et on n’a pas eu le temps de réparer le PCB avant la fin du cours. On n’a donc pas pu terminer les tests comme prévu.

## Cours 5A — Réparation des PCB (hors cours)

**Travail prévu :** Aucune période n’était prévue à l’échéancier. On a dû prendre de notre temps libre pour réparer les PCB et continuer le projet.

**Travail réalisé :** Will et moi avons refait entièrement un PCB. J’ai refait le stencil et repris les soudures des composants. J’ai aussi dessoudé la partie du circuit de recharge sur le premier PCB et remplacé la partie du circuit de protection USB, qui était brûlée. On a ensuite refait les tests électriques sur les deux PCB pour vérifier les tensions. À la fin des réparations, les deux PCB avaient les tensions nécessaires.

**Problèmes rencontrés :** Le capteur ENS160 devait être soudé à la main plutôt qu’au four. Comme il était très difficile à souder, ça nous a pris beaucoup plus de temps que prévu. On a dû reprendre plusieurs soudures et remplacer des composants endommagés. Finalement, on a réussi à souder le capteur correctement et à le faire fonctionner, puis à terminer les réparations et les tests électriques des deux PCB.

## Cours 6 bonus — Programmation et intégration du prototype

**Travail prévu :** Louis-Philippe nous a accordé un cours de plus pour continuer le projet, notamment la programmation et les tests du prototype.

**Travail réalisé :** Will avait déjà une première version du code, mais elle ne fonctionnait pas correctement. On a donc fait des recherches et des tests ensemble pour trouver les problèmes et corriger le programme. On travaillait en parallèle sur la même version de base du code, mais chacun sur un PCB différent. Will modifiait une partie du code pendant que je faisais des recherches, que je modifiais une autre partie et que je testais mes changements. J’ai trouvé des informations techniques qui nous ont aidés à corriger le programme et j’ai fait plusieurs tests de mon côté. Finalement, Will a réussi à obtenir une version fonctionnelle du code grâce aux recherches et aux essais qu’on a faits ensemble. À la fin du cours, on pouvait récupérer les informations de chaque capteur et les consulter sur notre téléphone avec l’application. On a aussi essayé d’installer le PCB dans le boîtier. La carte rentrait parfaitement, mais les boutons étaient trop longs et empêchaient de fermer correctement le boîtier. J’ai donc modifié les boutons dans Fusion 360 et préparé une nouvelle impression pour qu’on puisse les remplacer.

**Problèmes rencontrés :** La première version du code ne fonctionnait pas correctement. On a dû faire plusieurs recherches, modifications et essais avant d’obtenir un résultat fonctionnel. On a aussi découvert un problème avec la longueur des boutons pendant l’intégration mécanique. Il a fallu modifier leur conception et prévoir une nouvelle impression.
