BrunoSavard1/CI3-Noeud-de-capteur-/Journal/Journal_William_CI3_Noeud_capteur.docx

Semaine 0 - Cahier des charges

Travail prévu : Déterminer les requis du projet et commencer la conception du schéma électrique.

Travail réalisé : J’ai effectué des recherches sur les composants nécessaires au projet et ensuite fait la conception du schéma de concept.

Problèmes rencontrés : Les recherches sur certains composants ont révélé certaines contraintes, ce qui a entraîné des changements dans la structure de notre schéma de concept (et de notre idée du schéma électrique), surtout sur le plan de l’alimentation.

Semaine 1 - Schéma électrique

Travail prévu : Commencer la conception du schéma électrique.

Travail réalisé : J’ai commencé à travailler sur le schéma électrique du projet afin de préparer la conception du PCB. Pendant que je travaillais sur le schéma électrique, Bruno m’a aidé à trouver les pièces à utiliser, selon celles qui sont disponibles au cégep.

Problèmes rencontrés : Nous avons dû tenir compte des contraintes de consommation (en particulier, les peaks de courants) lors du choix des composants.

Semaine 2 - Routage du PCB et plan de test

Travail prévu : Vérifier le schéma électrique et commencer le routage du PCB.

Travail réalisé : J’ai travaillé sur le routage du PCB après avoir vérifié le schéma électrique avec mon coéquipier.

Problèmes rencontrés : En quête du point bonus, nous avons décidé de rendre notre PCB le plus compact possible. Cela a entraîné des contraintes physiques très strictes sur l’espace disponible pour le routage du PCB.

Semaine 3 - Conception du boîtier 3D

Travail prévu : Concevoir le boîtier 3D, poursuivre la programmation et compléter le plan de test.

Travail réalisé : J’ai travaillé sur plusieurs tâches, notamment la programmation (préparation de PlatformIO, puis programmation), le plan de test et la documentation. J’ai également réfléchi avec mon coéquipier à la conception du boîtier afin de trouver un design compact et fonctionnel.

Problèmes rencontrés : PlatformIO semblait avoir de la difficulté à créer un projet (plus de 30 minutes pour créer un projet, ce qui était très étrange). Il était aussi difficile de concevoir un boîtier compact tout en tenant compte des dimensions du PCB, de la batterie et des vis de fixation.

Semaine 4 - Refonte du boîtier et programmation

Travail prévu : Assembler le PCB et poursuivre la documentation ainsi que le plan de test.

Travail réalisé : Mon coéquipier et moi avons retravaillé le design du boîtier pour faciliter son assemblage. J’ai ensuite poursuivi le développement du programme (finalisation) et continué la documentation sur GitHub.

Problèmes rencontrés : Puisque les pièces n’étaient pas encore arrivées, nous avons dû réorganiser les tâches.

Semaine 5 - Assemblage du PCB

Travail prévu : Assembler le PCB, effectuer les premiers tests et réparer les problèmes éventuels.

Travail réalisé : Après avoir reçu les composants, mon coéquipier a assemblé le PCB. J’ai ensuite essayé d’intégrer la carte dans le boîtier.

Problèmes rencontrés : Le PCB a cessé de fonctionner pendant l’intégration mécanique. Le test de mise sous tension a échoué (smoke test failed).

Semaine 5.2 - Réparation des PCB (hors cours)

Travail prévu : Réparer les PCB et poursuivre le projet en dehors des heures de cours.

Travail réalisé : Mon coéquipier et moi avons refait un PCB, réparé les circuits endommagés et vérifié les tensions des deux cartes.

Problèmes rencontrés : Le capteur ENS160 était difficiles à souder. Nous avons dû reprendre plusieurs soudures et remplacer des composants avant d’obtenir des résultats satisfaisants (merci Dave!).

Semaine 6 (hors cours) - Programmation et intégration du prototype

Travail prévu : Poursuivre la programmation et effectuer les tests du prototype.

Travail réalisé : J’ai corrigé et testé le programme avec Bruno. Après quelques recherches et essais, nous avons réussi à récupérer les données des capteurs et à les obtenir sur notre téléphone via Bluetooth. Nous avons également testé l’intégration du PCB dans le boîtier.

Problèmes rencontrés : La première version du programme ne fonctionnait pas correctement. Nous avons aussi dû refaire imprimer les boutons car ils étaient trop grand pour le boitier et causaient le board à rester en mode reset.
