BrunoSavard1/CI3-Noeud-de-capteur-/Journal/Notes.docx

Semaine 1:

- Recherche sur les différentes composantes nécessaires.
- Début du schéma

Problèmes :

- Indécisions sur le choix du ESP32 (WROOM ou MINI)

Semaine 2:

- Review du schéma et correction (ou modification)
- Début du routage du PCB
- Fabrication du plan de test électrique.

Problèmes :

- Indécisions sur la taille du PCB (et les ramifications de cette décision)

Semaine 3 :

- Début du boitier 3D
- Recherche de « PlatformIO » (Programmation)
- Recherche des registres informatiques de tous les capteurs.
- Recherche de librairies (Arduino ou CircuitPython) pour les capteurs.

Problèmes :
