BrunoSavard1/CI3-Noeud-de-capteur-/Schematics/noeud_capteur_CWSB_SCH REV 1.00.PDF

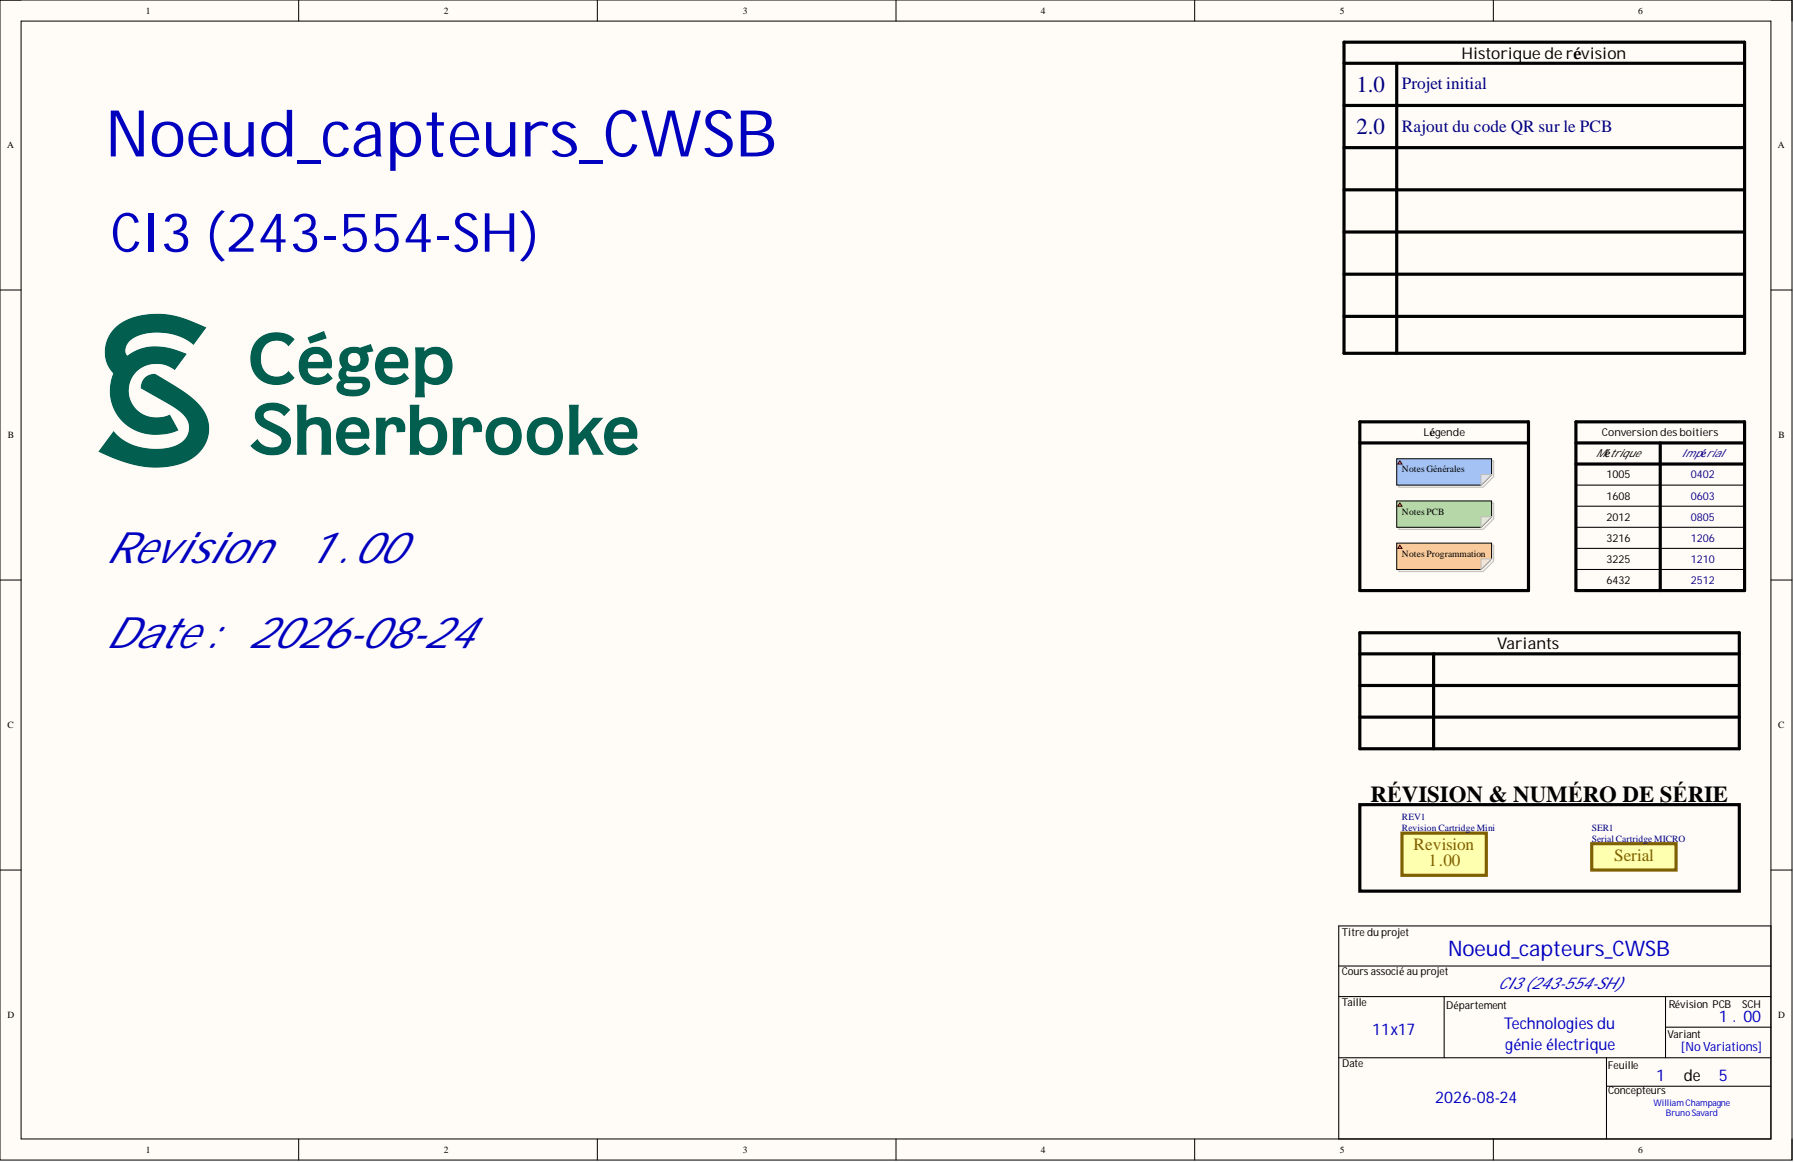
[picture p19: page 1]

1. 0 | Projet initia l

2. 0 | Rajo ut d u co de QR sur le PCB

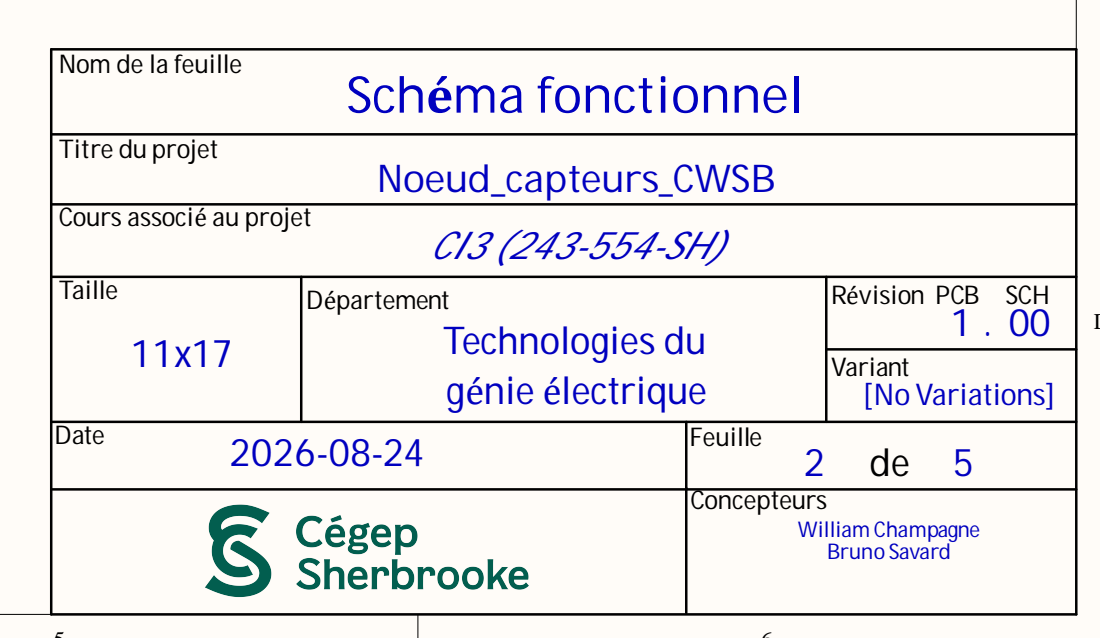
[picture p20: page 2]

Nom de la feuille

Cours associé au projet

Date 2026-08-24 | Feuille 2 de 5

Concepteurs William Champagne Bruno Savard

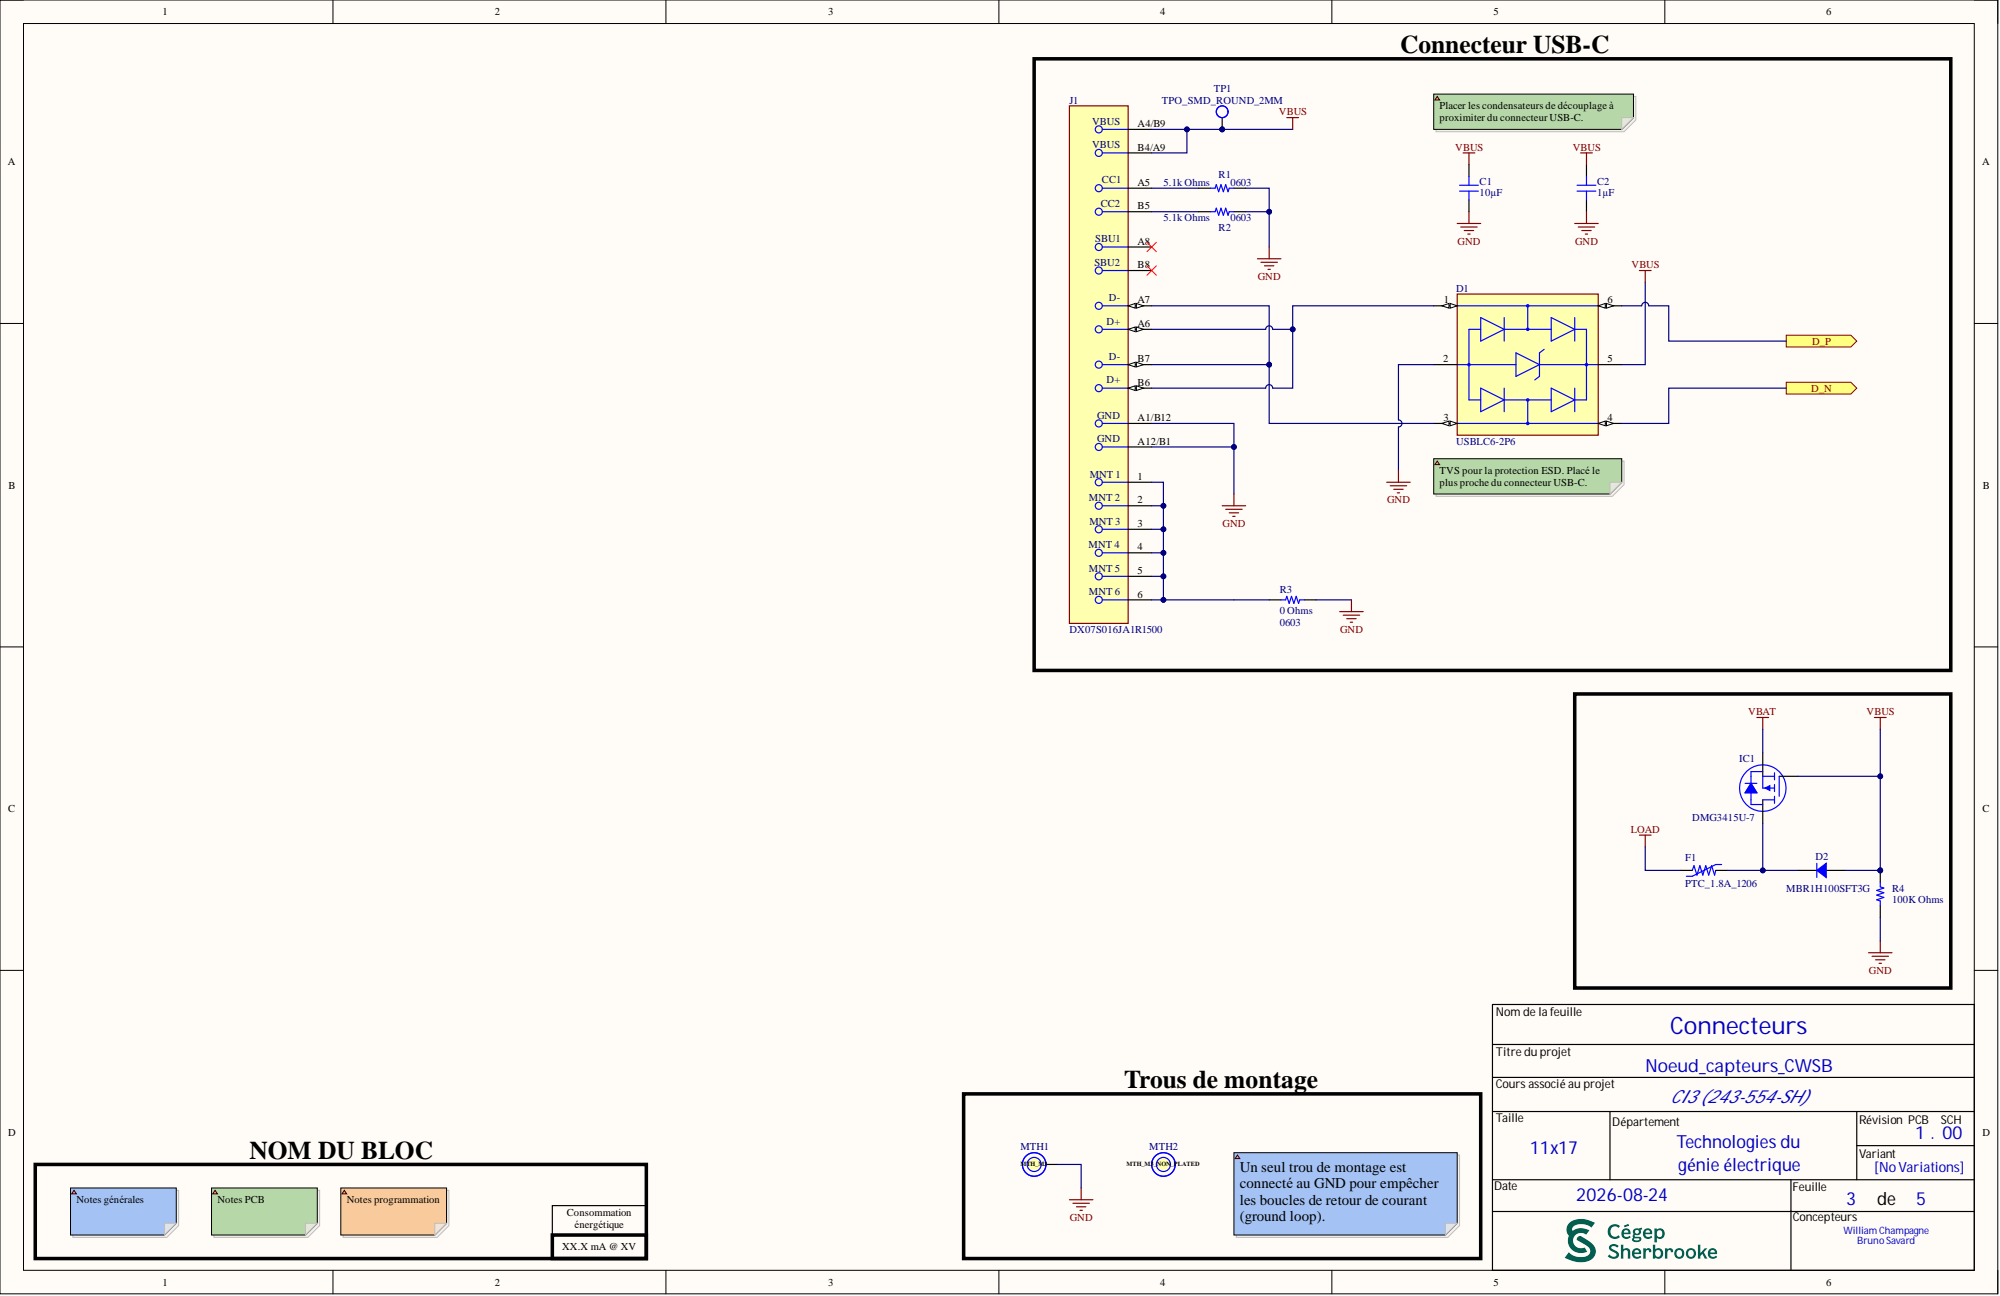
[picture p21: page 3]

Placer les condensateurs de découplage à
proximiter du connecteur USB-C.

TVS pour la protection ESD. Placé le
plus proche du connecteur USB-C.

Nom de la feuille

Cours associé au projet

MTH1 | MTH2 (ground loop).

Un seul trou de montage est
connecté au GND pour empêcher
les boucles de retour de courant

Date 2026-08-24 | Feuille 3 de 5

Notes générales Notes PCB Notes programmation

Concepteurs William Champagne Bruno Savard

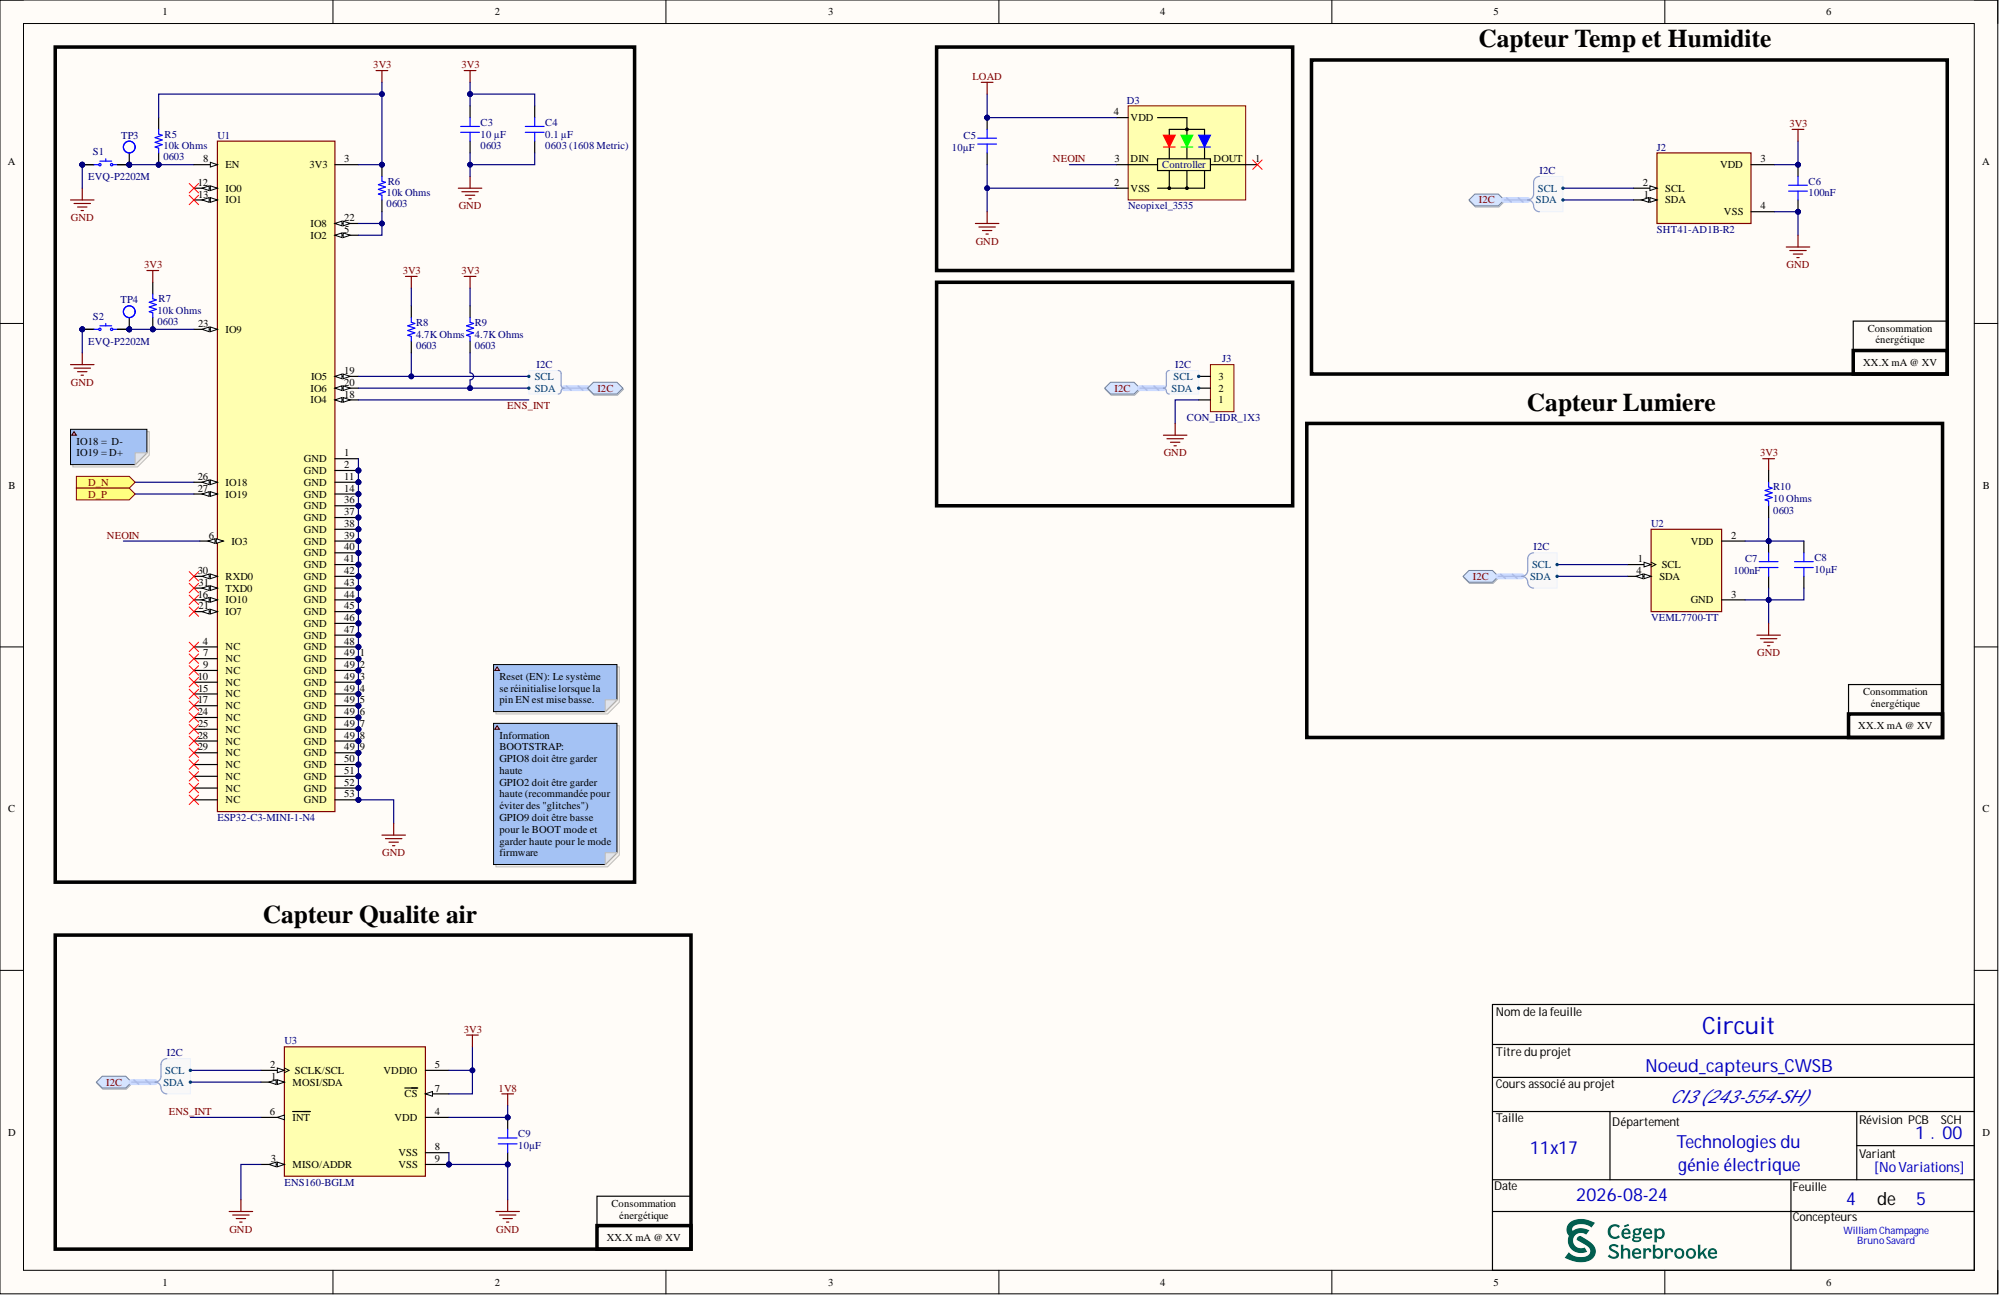
[picture p22: page 4]

3 V | 3 R1 0 1 0 O hms

Nom de la feui

D a te 6-08 - | Feui l l e d e

Concepteur s Willia m C h a m p a g n e Bru no Sava r d

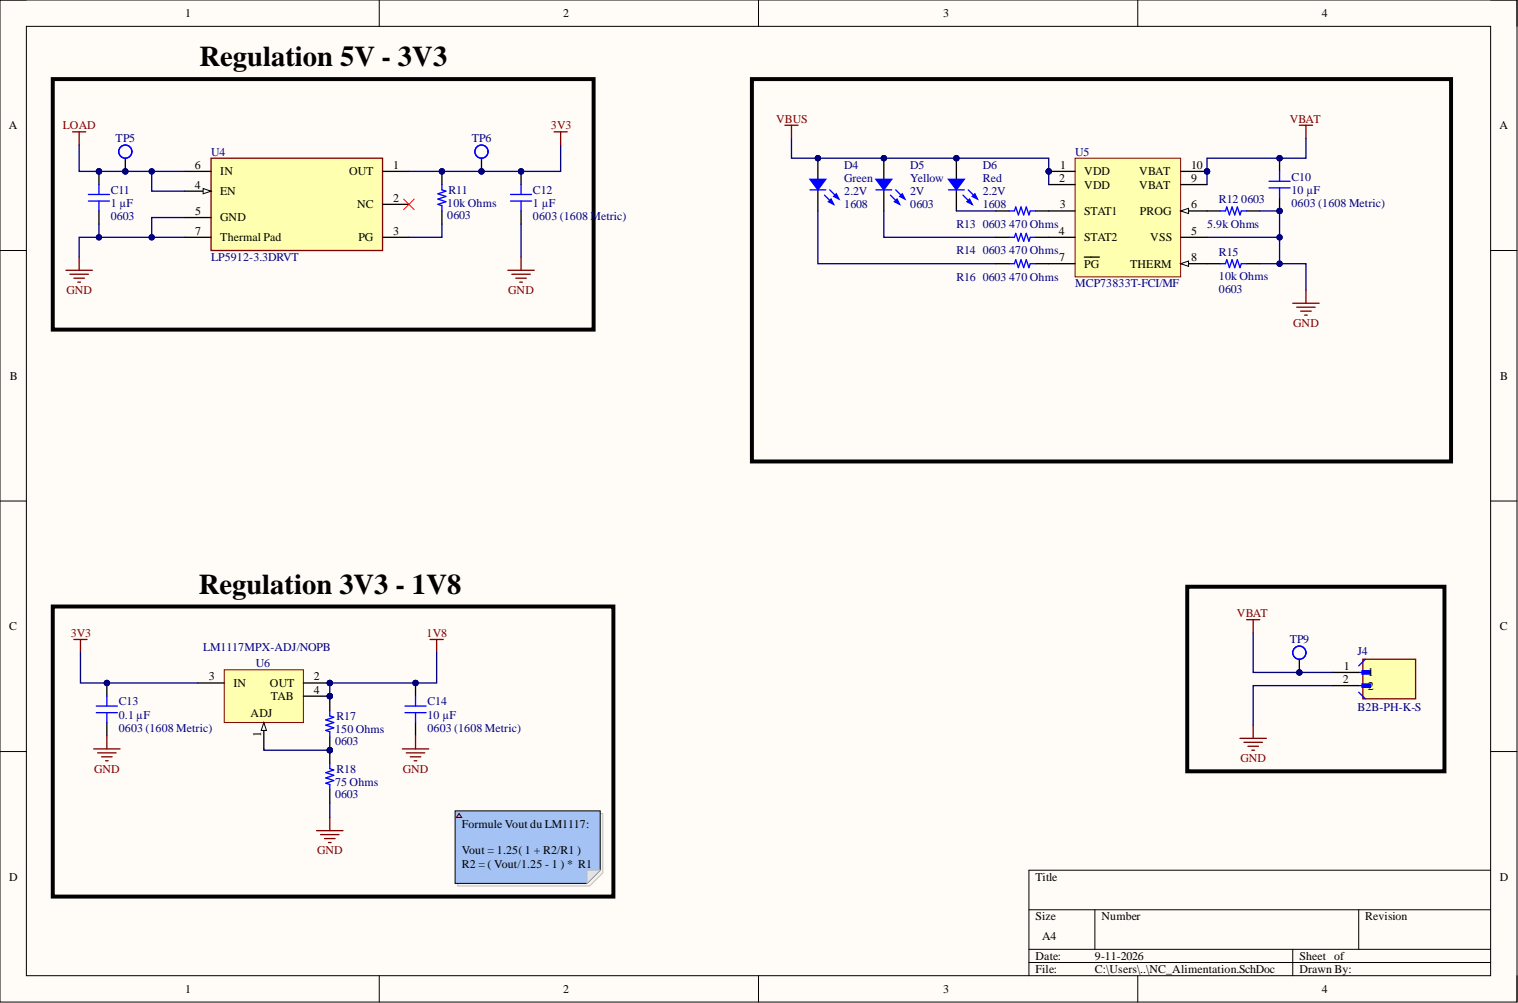
[picture p23: page 5]
