BrunoSavard1/CI3-Noeud-de-capteur-/PCB/PCB/noeud_capteur_CWSB_SCH REV 1.00.PDF

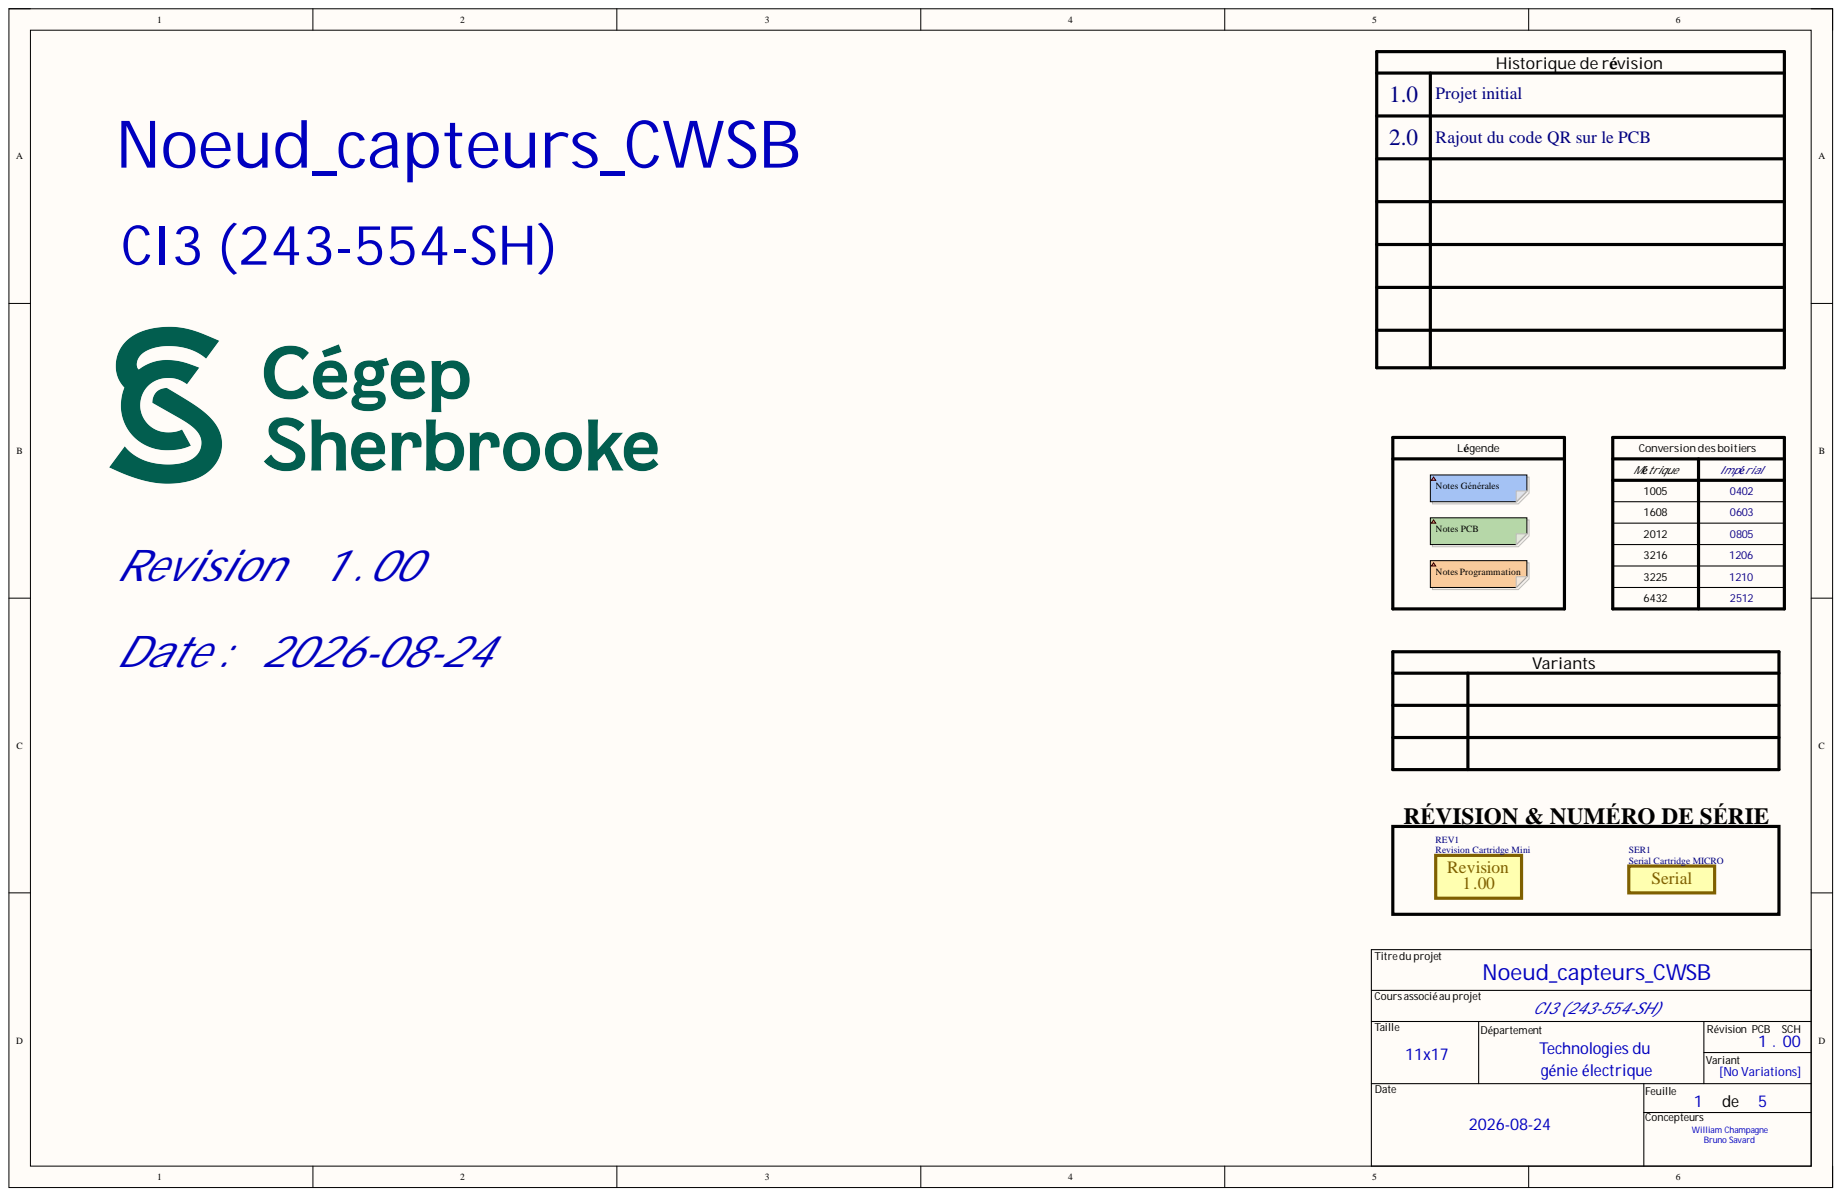
[picture p24: page 1]

1.0 | Projet initia l

2.0 | Rajo ut d u c o d e QR sur le PCB

Titr
B Cours associé au projet

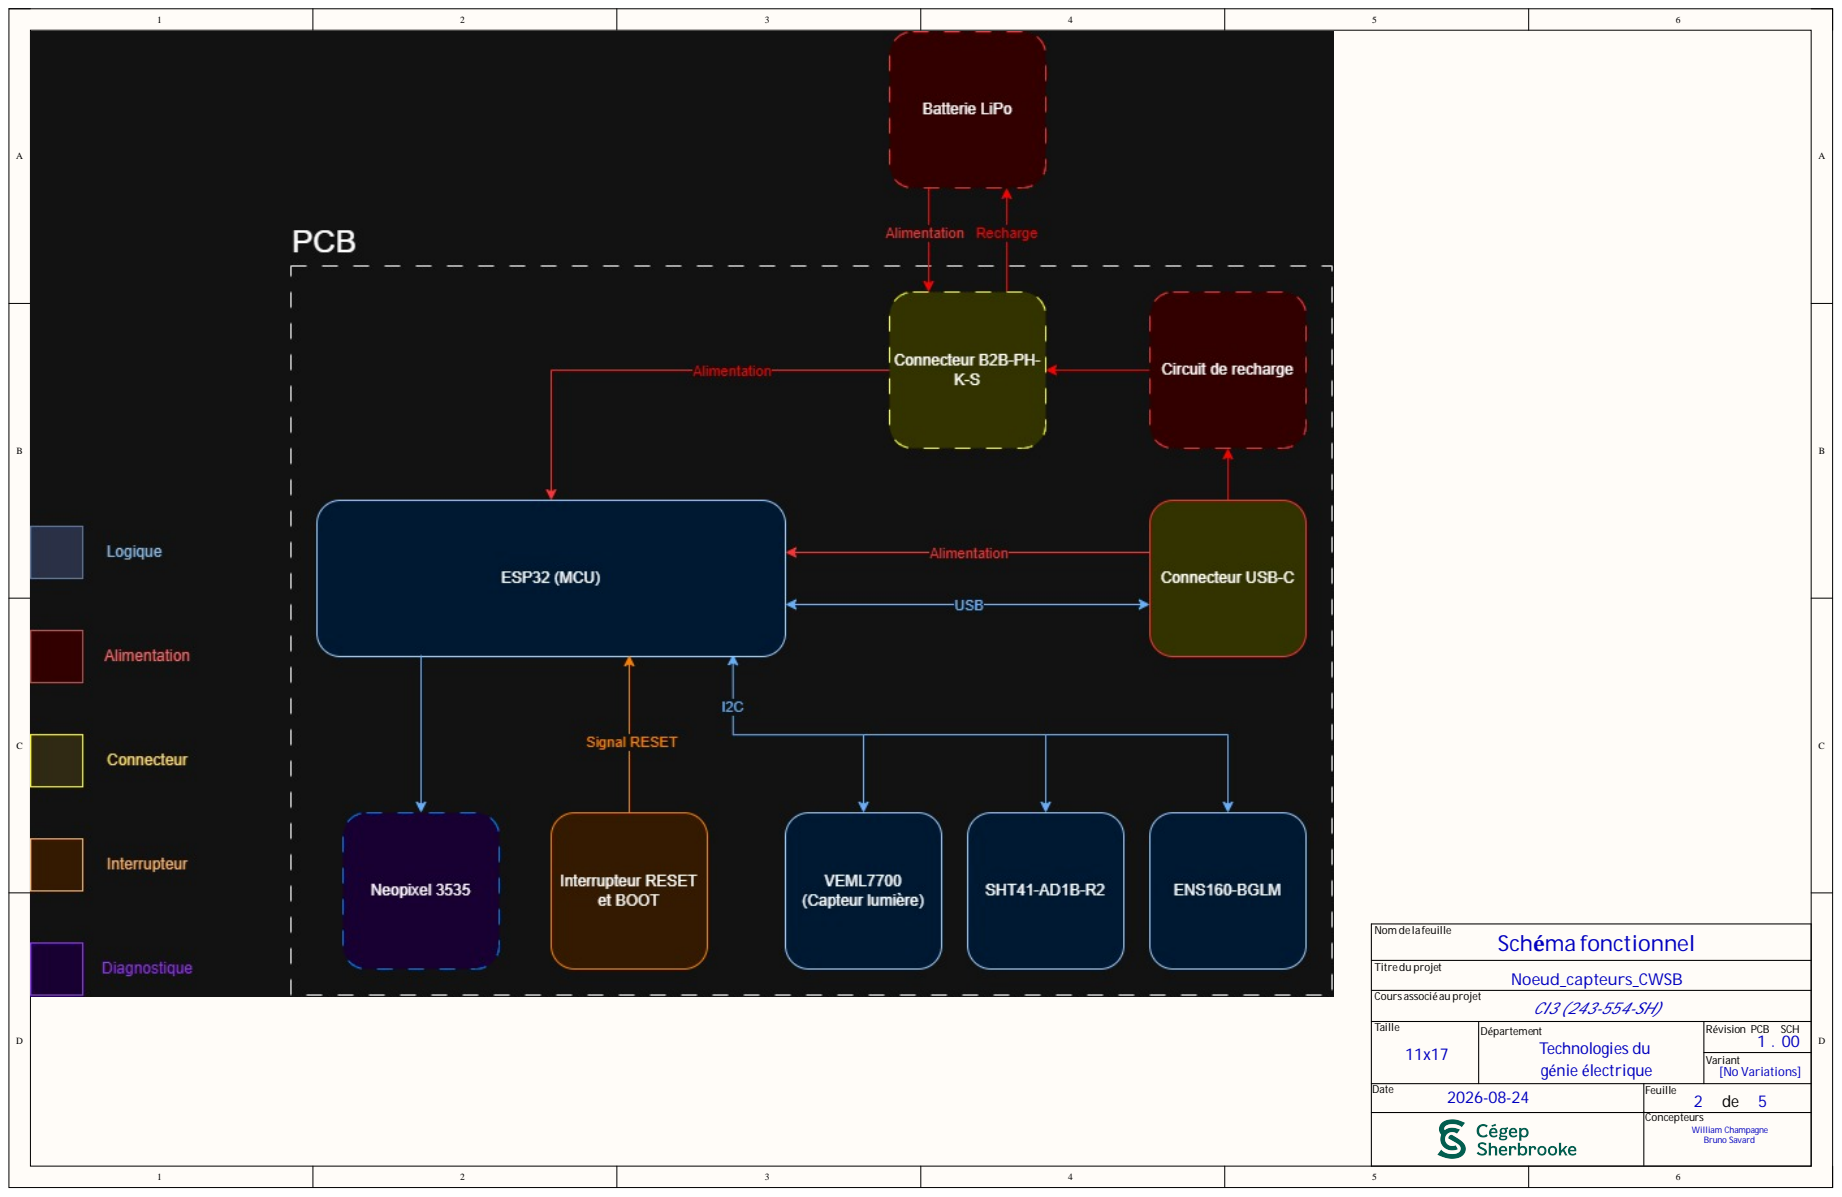
[picture p25: page 2]

Nom de la feuille

Titredu projet
Noeud_capteurs_CWSB Cours associé au projet

Date 2026-08-24 | Feuille 2 de Concepteurs 5

William Champagne Bruno Savard

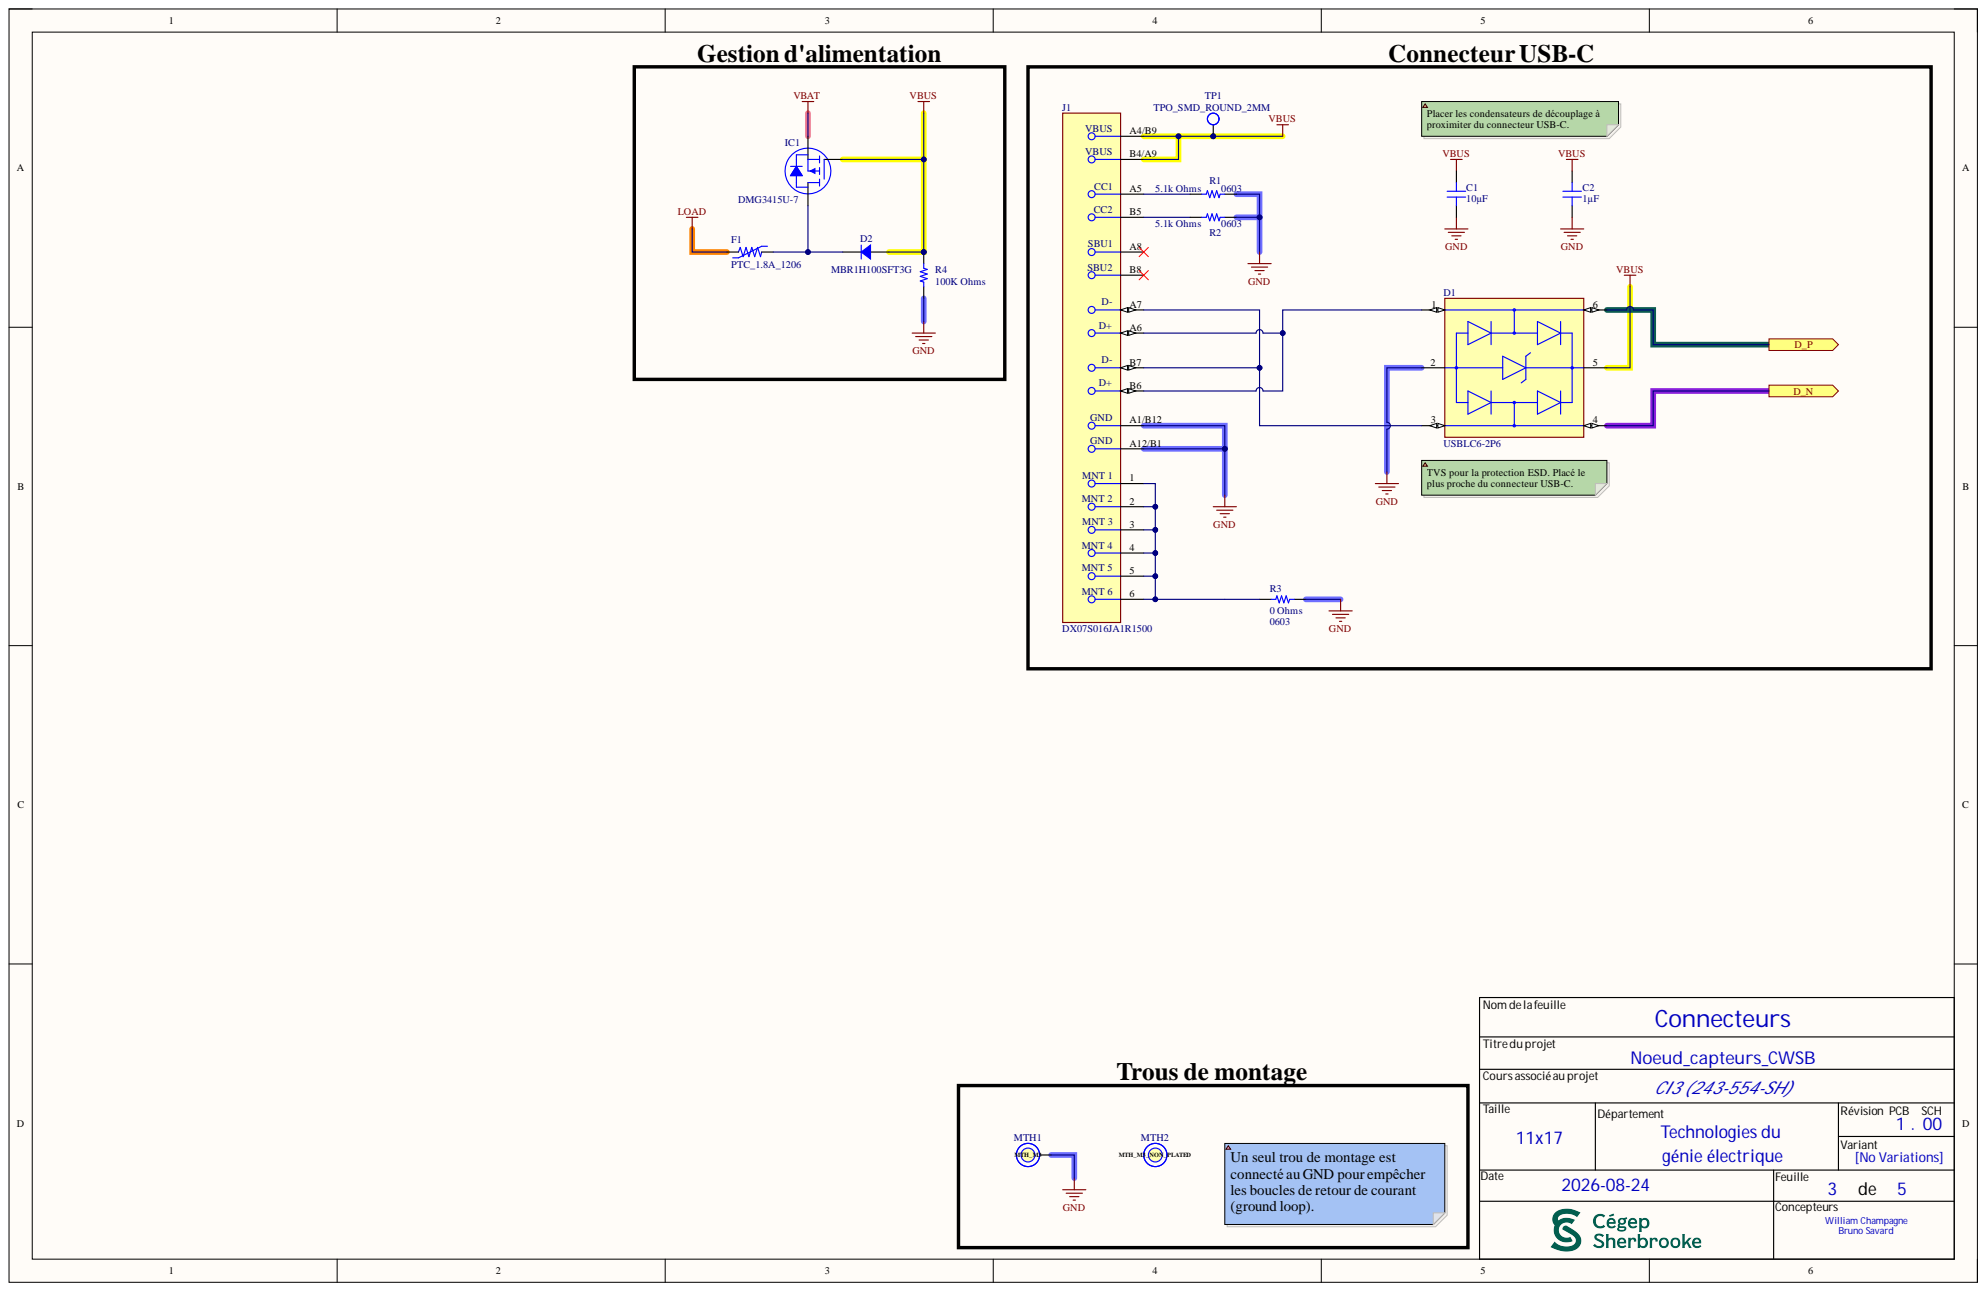
[picture p26: page 3]

Placer les condensateurs de découplage à
proximiter du connecteur USB-C.

TVS pour la protection ESD. Placé le
plus proche du connecteur USB-C.

Nom de la feuille

Titredu projet
Noeud_capteurs_CWSB Cours associé au projet

Un seul trou de montage est
connecté au GND pour empêcher
les boucles de retour de courant
(ground loop).

Date 2026-08-24 | Feuille 3 de Concepteurs 5

William Champagne Bruno Savard

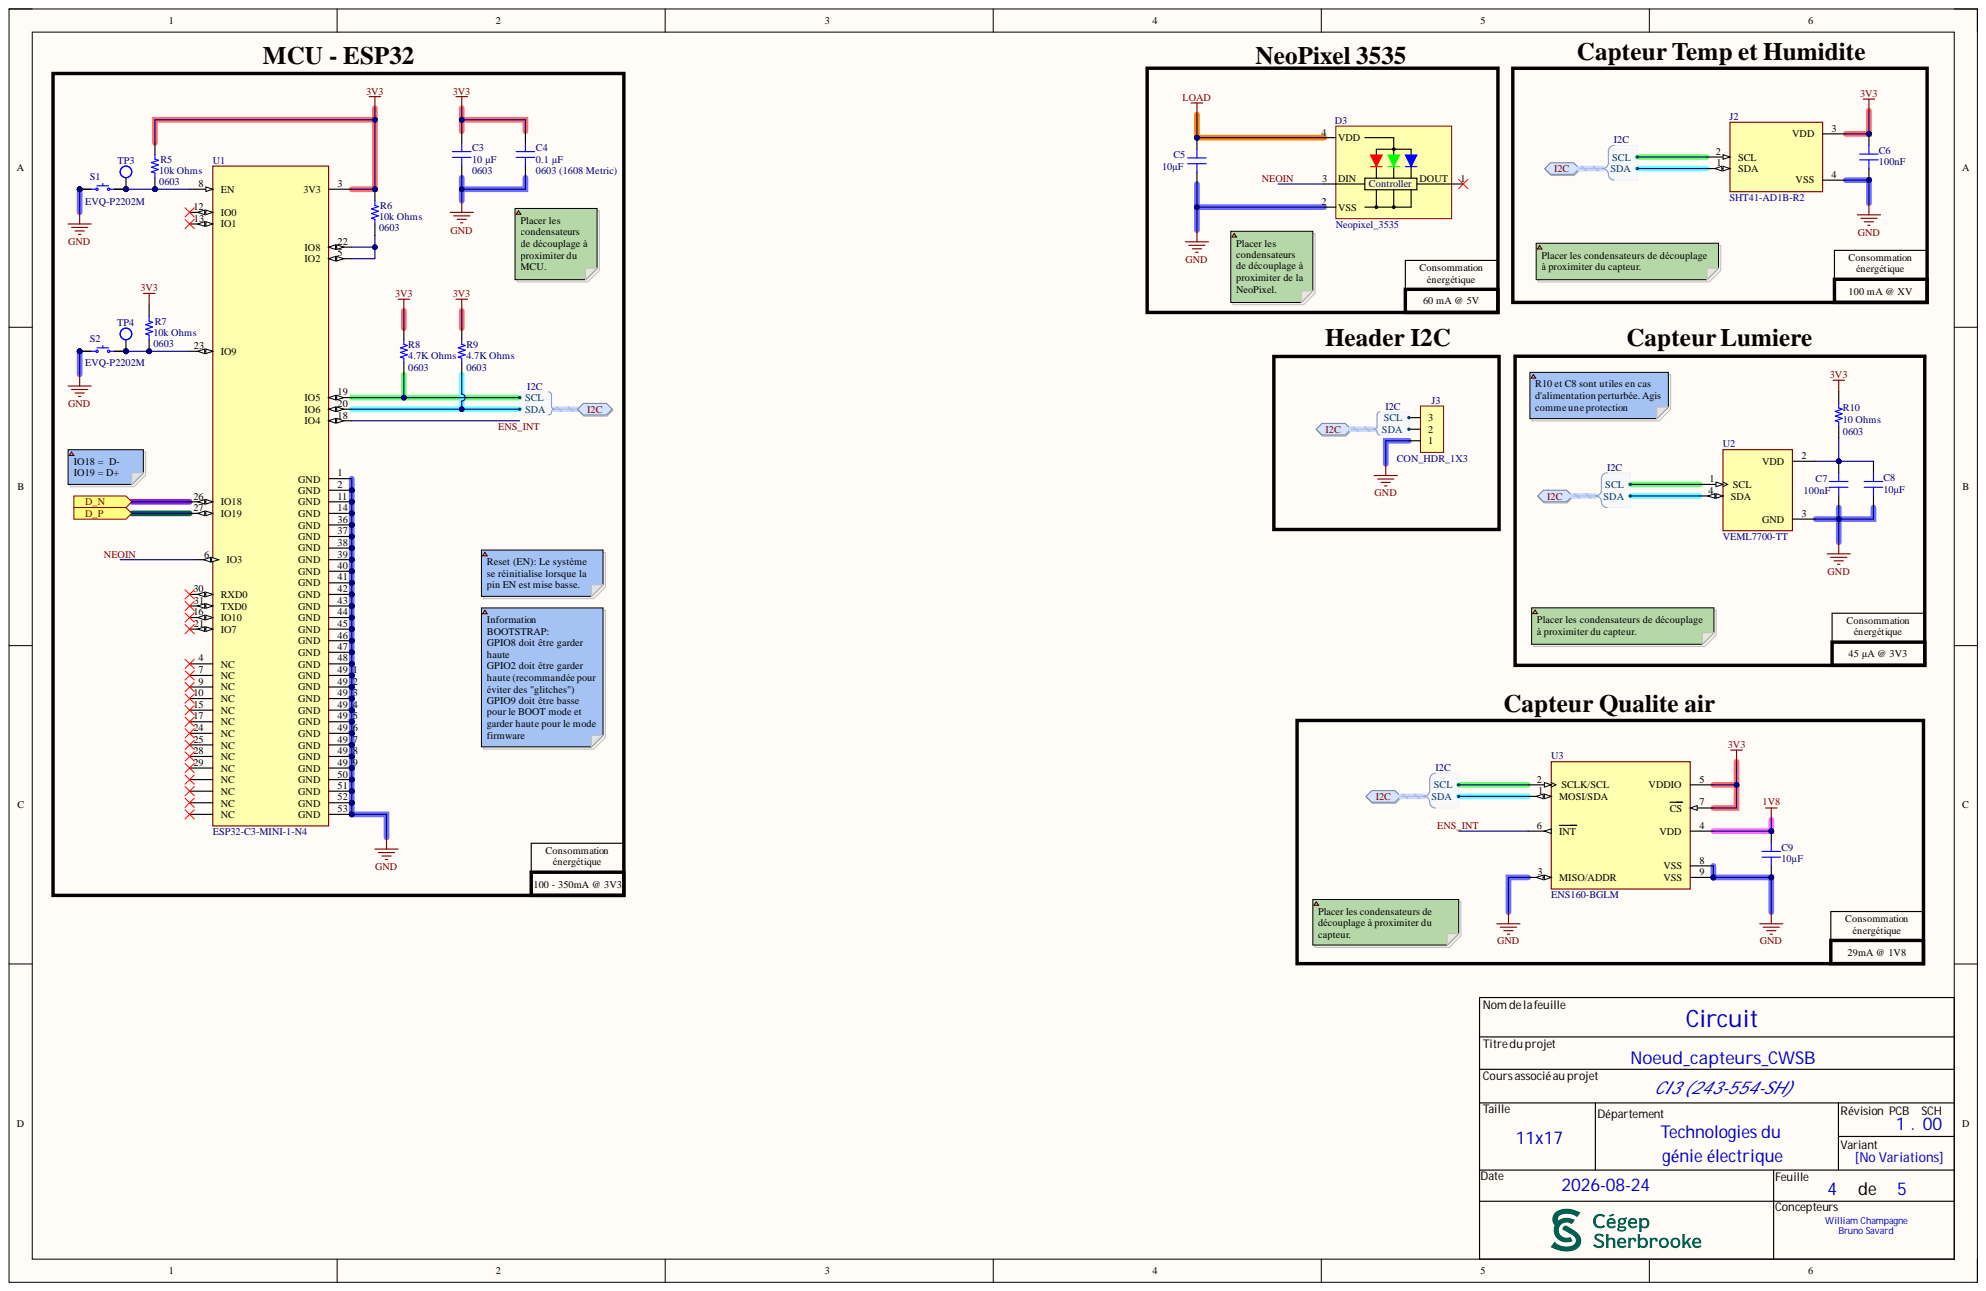
[picture p27: page 4]

Placer les condensateurs de
à proximiter du capteu

Reset (EN): Le syst
pin EN est

Placer les condensateurs de découplage à proximiter du

Titr
B Cours associé au projet

Date 2026-08-24 | Feuil l e 4 de Concepteurs 5

W i l l i am Ch amp agn e Bru no Sav ard

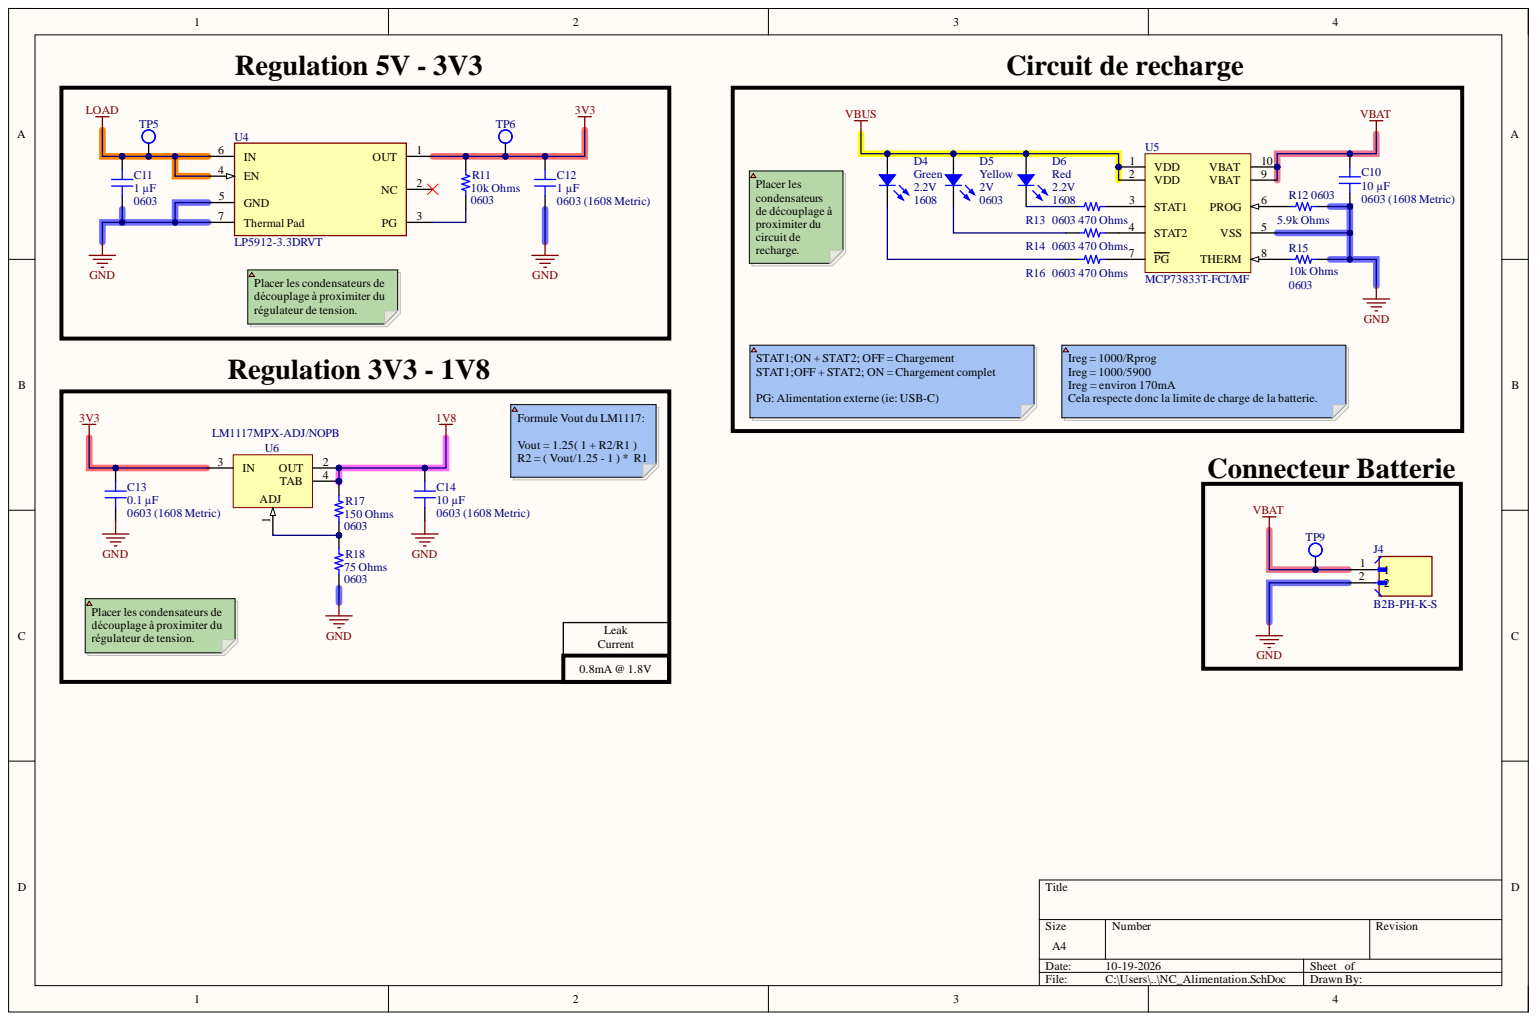
[picture p28: page 5]
