BrunoSavard1/CI3-Noeud-de-capteur-/(list of files, drawings)

Other design files:
PCB/PCB/nc_Circuit.SchDoc
PCB/PCB/NC_Connectors.SchDoc
PCB/PCB/noeud_capteur_CWSB.PrjPcb
PCB/PCB/project_files/NC_Alimentation.SchDoc
PCB/PCB/project_files/NC_overview.SchDoc
PCB/PCB/project_files/NC_PCB_4L.PcbDoc
PCB/PCB/project_files/NC_Title.SchDoc
PCB/PCB/project_files/noeud_capteur_CWSB.PrjPcb
