BrunoSavard1/CI3-Noeud-de-capteur-/(commit log)

2026-08-24 Structure Init commit
    Added a folder structure + concept schematic
2026-09-14 Nouvelle section Test + Fichier PCB
2026-10-08 Ajout de dossier PlatformIO
2026-10-19 final stage
2026-10-19 Add note about I2C header soldering
    Added a note to solder the I2C header only if needed.
